adsdevdoo/retro535/docs/pinout.md

# Выводы и разъёмы retro535

Вид сверху. Физические номера, а не номера битов. `_N` означает активный низкий уровень.

## SAB80535-N в PLCC-68

| Вывод | Функция | Цепь платы |
|---|---|---|
| 1 | P4_0 | P4_0 |
| 2 | P4_1 | P4_1 |
| 3 | P4_2 | P4_2 |
| 4 | VPD | GND |
| 5 | P4_3 | P4_3 |
| 6 | P4_4 | P4_4 |
| 7 | P4_5 | P4_5 |
| 8 | P4_6 | P4_6 |
| 9 | P4_7 | P4_7 |
| 10 | RESET_N | RESET_N |
| 11 | VAREF | AVREF |
| 12 | VAGND | GND |
| 13 | AN7 | AN7 |
| 14 | AN6 | AN6 |
| 15 | AN5 | AN5 |
| 16 | AN4 | AN4 |
| 17 | AN3 | AN3 |
| 18 | AN2 | AN2 |
| 19 | AN1 | AN1 |
| 20 | AN0 | AN0 |
| 21 | P3.0/RXD | RXD |
| 22 | P3.1/TXD | TXD |
| 23 | P3.2/P3_2_INT0_N | P3_2_INT0_N |
| 24 | P3.3/P3_3_INT1_N | P3_3_INT1_N |
| 25 | P3.4/P3_4_T0 | P3_4_T0 |
| 26 | P3.5/P3_5_T1 | P3_5_T1 |
| 27 | P3.6/WR_N | WR_N |
| 28 | P3.7/RD_N | RD_N |
| 29 | P1_7 | P1_7 |
| 30 | P1_6 | P1_6 |
| 31 | P1_5 | P1_5 |
| 32 | P1_4 | P1_4 |
| 33 | P1_3 | P1_3 |
| 34 | P1_2 | P1_2 |
| 35 | P1_1 | P1_1 |
| 36 | P1_0 | P1_0 |
| 37 | VBB | VBB |
| 38 | VSS | GND |
| 39 | XTAL2 | XTAL2 |
| 40 | XTAL1 | XTAL1 |
| 41 | P2.0/A8 | A8 |
| 42 | P2.1/A9 | A9 |
| 43 | P2.2/A10 | A10 |
| 44 | P2.3/A11 | A11 |
| 45 | P2.4/A12 | A12 |
| 46 | P2.5/A13 | A13 |
| 47 | P2.6/A14 | A14 |
| 48 | P2.7/A15 | A15 |
| 49 | PSEN_N | PSEN_N |
| 50 | ALE | ALE |
| 51 | EA_N | GND |
| 52 | P0.0/AD0 | D0 |
| 53 | P0.1/AD1 | D1 |
| 54 | P0.2/AD2 | D2 |
| 55 | P0.3/AD3 | D3 |
| 56 | P0.4/AD4 | D4 |
| 57 | P0.5/AD5 | D5 |
| 58 | P0.6/AD6 | D6 |
| 59 | P0.7/AD7 | D7 |
| 60 | P5_7 | P5_7 |
| 61 | P5_6 | P5_6 |
| 62 | P5_5 | P5_5 |
| 63 | P5_4 | P5_4 |
| 64 | P5_3 | P5_3 |
| 65 | P5_2 | P5_2 |
| 66 | P5_1 | P5_1 |
| 67 | P5_0 | P5_0 |
| 68 | VCC | +5V |

P0/AD0…7, P2/A8…15, P3.6/WR#, P3.7/RD#, ALE и PSEN# заняты памятью.
P1/P4/P5 доступны как GPIO; P4.0 также нагружен LED D3. P3.0/P3.1 заняты UART.
Аналоговые AN0…7 отдельны от GPIO. Дополнительные функции GPIO зависят от
SFR и прошивки — здесь указаны базовые имена; см. оригинальный Siemens datasheet.
P1/P3 также имеют таймерные/прерывающие функции. Все порты 5 В TTL.

## J2 — P1

| Контакт | Цепь |
|---|---|
| 1 | P1_0 |
| 2 | P1_1 |
| 3 | P1_2 |
| 4 | P1_3 |
| 5 | P1_4 |
| 6 | P1_5 |
| 7 | P1_6 |
| 8 | P1_7 |
| 9 | +5V |
| 10 | GND |

## J3 — P4

| Контакт | Цепь |
|---|---|
| 1 | P4_0 |
| 2 | P4_1 |
| 3 | P4_2 |
| 4 | P4_3 |
| 5 | P4_4 |
| 6 | P4_5 |
| 7 | P4_6 |
| 8 | P4_7 |
| 9 | +5V |
| 10 | GND |

## J4 — P5

| Контакт | Цепь |
|---|---|
| 1 | P5_0 |
| 2 | P5_1 |
| 3 | P5_2 |
| 4 | P5_3 |
| 5 | P5_4 |
| 6 | P5_5 |
| 7 | P5_6 |
| 8 | P5_7 |
| 9 | +5V |
| 10 | GND |

## J5 — ANALOG

| Контакт | Цепь |
|---|---|
| 1 | AN0 |
| 2 | AN1 |
| 3 | AN2 |
| 4 | AN3 |
| 5 | AN4 |
| 6 | AN5 |
| 7 | AN6 |
| 8 | AN7 |
| 9 | AVREF |
| 10 | GND |

## J6 — P3 / UART

| Контакт | Цепь |
|---|---|
| 1 | RXD |
| 2 | TXD |
| 3 | P3_2_INT0_N |
| 4 | P3_3_INT1_N |
| 5 | P3_4_T0 |
| 6 | P3_5_T1 |
| 7 | RESET_N |
| 8 | GND |

## J7 — BUS RESERVED

| Контакт | Цепь |
|---|---|
| 1 | D0 |
| 2 | D1 |
| 3 | D2 |
| 4 | D3 |
| 5 | D4 |
| 6 | D5 |
| 7 | D6 |
| 8 | D7 |
| 9 | A0 |
| 10 | A1 |
| 11 | A2 |
| 12 | A3 |
| 13 | A4 |
| 14 | A5 |
| 15 | A6 |
| 16 | A7 |
| 17 | A8 |
| 18 | A9 |
| 19 | A10 |
| 20 | A11 |
| 21 | A12 |
| 22 | A13 |
| 23 | A14 |
| 24 | A15 |
| 25 | PSEN_N |
| 26 | ALE |
| 27 | RD_N |
| 28 | WR_N |
| 29 | +5V |
| 30 | GND |

## JP1 — RUN - FIT AFTER FT_PROG

| Контакт | Цепь |
|---|---|
| 1 | PWREN_N |
| 2 | EN_N |

## JP2 — USB RX LINK

| Контакт | Цепь |
|---|---|
| 1 | UART_RX_BUF |
| 2 | RXD |

Двухрядные колодки: пары 1/2, 3/4 и т. д.; не читать один ряд как 1…5.
Квадратная площадка и цифра 1 задают начало нумерации. J7 — только диагностика
шины, без внешних драйверов и длинного шлейфа. JP2 открыть для внешнего источника RXD.
J5.9 AVREF — выход опоры, не подавать на него внешнее напряжение.
Контрольные точки и ожидаемые уровни — в `bring-up.md`.
