adsdevdoo/retro535/reports/release-review.md

# Выпуск retro535 v1.0 — 2026-11-08

Статус: производственные файлы для пробной партии инженерного прототипа.
Работа в железе и DFM на стороне JLCPCB ещё не проверены. Покупку, заказ
и загрузку в JLCPCB агент не выполнял; их выполняет владелец платы.

## Выполненные проверки

| Проверка | Результат / свидетельство |
|---|---|
| KiCad 9.0.2 ERC | 0 ошибок, 0 предупреждений; erc.rpt |
| DRC с проверкой соответствия схеме | 0 violations, 0 unconnected, 0 schematic_parity; drc.json |
| Габарит / слои | 100 × 80 мм по оси контура, 2 слоя; pcb-geometry.json |
| Контур | Замкнут; 8 прямых и 2 дуги, вырез USB 0,81 мм с R0,5 |
| Gerber | Независимо прочитаны Gerbonara: 7 слоёв, верх/низ просмотрены; manufacturing-audit.json |
| Excellon | Каждое отверстие сверено с PCB: 452 круглых PTH, 4 PTH-паза USB, 6 NPTH; допуск сравнения координат 0,0011 мм |
| Архив | 9 файлов, CRC ZIP и SHA-256 каждого вложенного файла проверены; fabrication/SHA256SUMS.txt |
| Шелкография | Обе стороны просмотрены; высота текста ≥1 мм, штрих ≥0,15 мм. Метки первого вывода и разъёмы читаются с одной стороны. TP5/6 и TP7/8 симметричны. |
| 3D | 82 footprints: 68 компонентов имеют локальные модели, исключения — 10 TP и 4 крепёжных отверстия. Проверены верх, низ и наклонный вид; models-audit.json |
| Схема PDF | Четыре листа A3 экспортированы и визуально просмотрены |
| Прошивка | SDCC 4.5; uCsim C52: нормальный запуск, UART и SRAM PASS; намеренное повреждение SRAM даёт FAIL. См. firmware-simulation.json и журналы. |

SHA-256 PCB: `c7ce883b42bb6e790ba64095abc71b3cd030f23d9340032d43f80b06584954aa`.
SHA-256 производственного ZIP:
`d14278da3402d24a2d8b044cfb277295d6679295cfe38f7234b9b80359c70983`.

## Предупреждения и границы проверки

Оставшихся ERC/DRC-предупреждений нет. Первоначальные расхождения NC-сетей,
признака BOM тестовых точек и геометрии локальной библиотеки исправлены,
а не исключены из проверки. Передние PTH-пазы USB увеличены до 0,6 × 1,4 мм
по чертежу HRO; задние 0,6 × 1,7 мм. Край PCB согласован с чертежом.

Gerbonara предупреждает о G90 после заголовка Excellon: это вывод KiCad,
координаты прочитаны как абсолютные и полностью совпали с PCB. При рендере
также сообщает о лишних неиспользованных параметрах RoundRect и отсутствии
paste-слоёв. Слои пасты намеренно не входят в заказ пустых PCB без трафарета.
Эти сообщения не являются подтверждением фабричного DFM.

У U1/U3/U4 на рендерах пустые панели. Модель U1 условная: корпус 30,07 мм
вместо 30,22 мм, в STEP отсутствует один хвост, тогда как PCB имеет все
68 контактов. F1, кварц и прочие типовые корпуса не являются официальным
CAD каждого производителя. Источники и условия распространения — docs/models.md.
Визуальный осмотр не заменяет измерение физических купленных компонентов.

Симулятор C52 проверяет исполняемый код, UART и SRAM, но не электрическую
работу SAB80535-N, ADC, RESET, USB, питание или задержки реальной шины.
Первая прошивка и последующие обновления требуют внешнего программатора
и извлечения Flash при отключённом питании. UART не прошивает эту плату.

JP1 первоначально открыт; FT232RL требуется настроить через FT_PROG на
500 mA и PWREN#. Для надёжного снятия RESET TP3 должен быть выше 4,75 В
под нагрузкой. При длинном кабеле или слабом USB-порту это не гарантировано;
повышающего стабилизатора в v1.0 нет. Следовать docs/bring-up.md.
