adsdevdoo/retro535/docs/models.md

# 3D-модели retro535

Модели находятся в `hardware/3d`, пути в PCB — `${KIPRJMOD}/3d/...`.
Это CAD-визуализация платы 100 × 80 мм, а не фото прототипа. На изображениях
U1, U3, U4 показаны **пустые панели**, без вставленных МК, Flash и SRAM.
JP1/JP2 показаны без съёмных шунтов. Крепёж в отверстиях не установлен.

## Источники и ограничения

| Позиция | Файл / источник | Статус и преобразование |
|---|---|---|
| J1 | `HRO_TYPE-C-31-M-12_aligned.step`; [ai03-2725/Type-C.pretty](https://github.com/ai03-2725/Type-C.pretty/blob/master/HRO%20%20TYPE-C-31-M-12.step) | Сторонняя модель для указанного HRO. Исходник сохранён как `HRO_TYPE-C-31-M-12_ai03.step`. Поворот +90° X, перенос (-4,47; -3,65; 0) мм внесены в STEP. Явная лицензия исходного репозитория не найдена; авторство ai03-2725. Это не официальный CAD HRO. |
| U1, панель | `PLCC68_THT_70207015_illustrative.step`; [LemaruX/Amiga-A600-68k-PLCC2DIP-v2](https://github.com/LemaruX/Amiga-A600-68k-PLCC2DIP-v2/blob/main/3d/70207015.stp) | Иллюстративная THT-панель, не официальный CAD Preci-Dip 540-99-068-24-000-1. Корпус 30,07 мм вместо номинальных 30,22 мм выбранной панели. Перенос (0; -12,7; +7,66) мм, добавлен тёмный цвет. В исходном STEP отсутствует один хвост вывода (позиция pad 2); остальные 67 совпадают с сеткой отверстий. Все 68 площадок PCB сохранены. Не использовать эту модель как шаблон сверления. |
| F1 | `MF-MSMF075_adom_illustrative.step`; [Adom / Ray](https://wiki.adom.inc/adom/mf-msmf075/files/mf-msmf075.step) | Скачанная условная модель 1812, CC-BY-SA-4.0. Габарит XY 4,52 × 3,22 мм. Высота исходника 0,9 мм; в PCB масштаб Z=0,7/0,9 даёт 0,7 мм. [Bourns MF-MSMF](https://www.bourns.com/docs/product-datasheets/mf-msmf.pdf) для MF-MSMF075: A=4,37…4,73; B=3,07…3,41; C=0,55…0,85 мм. Детальная форма и цвет условные. Это не CAD производителя. |
| Y1 | `Crystal_HC49-4H_Vertical.step`, библиотека KiCad | Условный низкий HC49, шаг выводов 4,88 мм. Масштаб Z=3,5/4,1. Исправлен MPN на THT **ECS-110.5-20-4X**, CL20 пФ, 11,0592 МГц. [Чертёж ECS](https://www.ecsxtal.com/store/pdf/hc-49usx.pdf). Подробная форма корпуса не сертифицирована как CAD ECS. |
| Остальные | Локальные копии из установленной KiCad 9, `share/kicad/3dmodels` | Типовые модели соответствующего корпуса; не фирменные модели каждого MPN. Источник: [KiCad packages3D](https://gitlab.com/kicad/libraries/kicad-packages3D), лицензия библиотеки CC-BY-SA-4.0 с исключением KiCad. |

Лицензия исходного репозитория панели — CC-BY-NC-SA-4.0, копия в
`hardware/3d/sources/PLCC68-LICENSE.txt`. В заголовке STEP указан TraceParts;
отдельное разрешение Preci-Dip на эту модель не установлено. При повторном
распространении сохранять авторство, условия и сведения об изменениях.
Условия сторонних моделей не изменяют лицензию остальных файлов проекта.

`reports/models-audit.json` перечисляет **каждый** footprint, файлы моделей,
их SHA-256, смещения, повороты и масштаб. Исключения: десять плоских TP и
четыре крепёжных отверстия. Автоматическая проверка наличия файлов не
доказывает совпадение всех размеров с изделиями. Проверка в 3D — внешний
вид, отсутствие очевидных смещений и совмещение с платой; посадочные места
проверяются отдельно по datasheet. Модель не является основанием менять
нумерацию или координаты площадок.

Для повтора: KiCad Python `tools/complete_models.py`, затем
`tools/audit_models.py`; после этого обязательно открыть рендеры сверху,
снизу и под углом. Генератор схемы сохраняет отредактированные локальные
footprints, а не заменяет их копиями из системной библиотеки.
