adsdevdoo/retro535/docs/architecture.md

# retro535 — архитектура v1.0

Siemens SAB80535-N Retro Development Board. Проект для имеющегося у владельца
**SAB80535-N** в съёмной панели **PLCC-68**. Номинальный размер 100 × 80 мм,
два слоя, FR-4 1,6 мм, 1 oz. Производитель платы — JLCPCB. Физический
прототип не изготовлен и не испытан. Статус выпуска определяется актуальными
отчётами в `reports/`, а не наличием изображения платы.

## Проверенный контроллер

Использован оригинальный скан Siemens **SAB80515/SAB80535**, а не datasheet
SAB80C535. Таблица заказа на странице PDF 2 прямо содержит **SAB80535-N,
Q67120-C241, P-LCC-68, external memory**. Общая документация включает две
микросхемы: утверждения о внутренней ROM у 80515 к нашему 80535 не относятся.

- SAB80535 — микроконтроллер: ядро MCS-51, 256 байт внутренней RAM, GPIO,
  таймеры, UART и 8-канальный 8-битный АЦП. Внутренней памяти программ нет.
- Питание 5 В ±10%, исполнение -N: 0…70 °C. Допустимый диапазон частот
  1,2…12 МГц; выбран кварц 11,0592 МГц для точного UART 9600 бод.
- **RESET, вывод 10, активен НИЗКИМ уровнем.** Это принципиальное отличие
  от многих других MCS-51. Минимальная длительность сброса — 24 периода
  работающего генератора. MCP120-475I/SN удерживает сброс после восстановления
  питания минимум 150 мс; R7 10 кОм подтягивает линию вверх, SW1 замыкает её
  на землю. Порог MCP120-475: 4,50…4,75 В; гарантированный выход из сброса
  требует питания выше 4,75 В.
- **EA, вывод 51, постоянно на GND**: все команды читаются извне.
- **VBB, вывод 37: только C12 100 нФ на GND.** Это вывод внутреннего
  смещения подложки; его нельзя непосредственно соединять с GND или +5 В.
- VPD, вывод 4, на GND: резервное питание внутренней RAM не используется.
- VCC=68, VSS=38; VAREF=11, VAGND=12. Аналоговая опора от +5 В через R8
  10 Ом, с 100 нФ и 1 мкФ. Это отфильтрованное питание, не прецизионный
  источник. Падение на R8 и шум питания нужно измерить и учитывать при АЦП.
- XTAL1=40, XTAL2=39. Кварц ECS-110.5-20-4X (THT HC-49USX, шаг 4,88 мм,
  высота до 3,5 мм), два C0G по 30 пФ. Первоначальный ABLS ошибочно
  соответствовал SMD-корпусу; MPN исправлен, отверстия платы не изменены.
  Siemens рекомендует 30±10 пФ. Эквивалентная нагрузка двух конденсаторов
  около 15 пФ плюс паразитная ёмкость; точность частоты и запуск проверяются
  на прототипе. Концы неполярного кварца можно поменять местами.
- ALE=50, PSEN=49. Внешние схемы не должны активно управлять ими при сбросе:
  эти линии участвуют в заводских тестовых режимах. Внешних драйверов нет.
- P0.0…P0.7=52…59: мультиплексированная шина AD0…AD7. В режиме внешней
  памяти у порта есть внутренние активные подтяжки; внешние резисторы не нужны.
- P2.0…P2.7=41…48: A8…A15. P3.6=27 — WR#, P3.7=28 — RD#.
- AN0…AN7=20…13: подтяжки 100 кОм к GND задают уровни отключённых входов.
  Они нагружают внешние источники. Неиспользованные GPIO остаются входами
  квазидвунаправленных портов после сброса; не замыкать их напрямую на питание.

Подробная таблица всех физических выводов и разъёмов — `pinout.md`.

## Карта памяти и внешняя шина

| Пространство | Адреса | Устройство | Управление |
|---|---|---|---|
| CODE | 0000h…FFFFh | Нижние 64 КиБ SST39SF010A | CE#=0; OE#=PSEN#; WE#=+5 В |
| XDATA | 0000h…7FFFh | 32 КиБ AS6C62256A | CE#=A15; OE#=RD#; WE#=WR# |
| XDATA | 8000h…FFFFh | Не установлено | Чтение не определено |
| Внутренняя RAM | 00h…FFh | 256 байт внутри МК | Верхняя половина — косвенная адресация |
| SFR | 80h…FFh | Регистры периферии | Прямая адресация; отдельна от RAM |

CODE и XDATA — **разные пространства по 64 КиБ**, не единая линейная память
128 КиБ. Команды читаются через PSEN#, данные через MOVX и RD#/WR#.
SN74HCT573 захватывает A0…A7 с AD0…AD7 по ALE; OE# защёлки постоянно низкий.
При CODE-чтении SRAM не выдаёт данные, потому что RD# не активен. При MOVX
Flash не выдаёт данные, потому что PSEN# не активен. Эти условия исключают
одновременное управление шиной со стороны двух памятей в штатных циклах.

SST39SF010A имеет 128 КиБ, но **A16 (вывод 2) жёстко на GND**. Используются
физические адреса 00000h…0FFFFh; 10000h…1FFFFh недоступны. Банкового регистра
в v1.0 нет. CE#, OE#, WE# и все адресные входы имеют определённые подключения.
NC выводы 1 и 30 действительно не подключены. RD#/WR# подтянуты к +5 В
через 10 кОм; Flash WE# не связан с WR#.

74HCT139 не установлен: для одного окна SRAM 32 КиБ достаточно A15 прямо на
активный низкий CE#. Дополнительный дешифратор добавлял бы задержку и
потребление без необходимой функции.

## Выбор компонентов и уровни

| Узел | Выбор | Причина |
|---|---|---|
| Панель U1 | Preci-Dip 540-99-068-24-000-1 | Съёмный PLCC-68, сквозные выводы |
| Защёлка U2 | SN74HCT573DWR | TTL-пороги, SOIC-20W с шагом 1,27 мм |
| CODE U3 | SST39SF010A-70-4C-PHE | 5 В, 70 нс, PDIP32 в панели |
| XDATA U4 | AS6C62256A-70PCN | 5 В, 70 нс, PDIP28; VIH=2,2 В |
| USB-UART U5 | FT232RL | Настраиваемые 500 мА и PWREN# для питания после enumeration |
| Питание U6 | TPS2041BDR | Ключ с ограничением тока/температуры, активный низкий EN |
| Сброс U7 | MCP120-475I/SN | Активный низкий открытый сток; контроль просадки |
| UART U8 | SN74AHCT125DR | TTL-входы и отключаемые выходы при сбросе/выключенном МК |

Siemens гарантирует VOH ≥2,4 В, а не близкий к питанию CMOS-уровень.
Поэтому HCT/AHCT предпочтительны HC/AHC: их VIH=2,0 В. У SST39SF010A
также TTL-пороги. Первоначальный кандидат **AS6C62256 без A** имеет VIH=2,4 В:
формально верхний уровень совпадает с минимумом выхода МК, запаса нет.
Поэтому выбрана **AS6C62256A** с VIH=2,2 В: гарантированный статический запас
0,2 В. Это небольшой запас; шину нельзя произвольно удлинять или нагружать.
AS6C62256A — устаревшая позиция; перед закупкой проверить подлинность и наличие.
Не заменять её на похожую 62256 без повторной проверки VIH, тока и времени.

По низкому уровню VO(L) МК ≤0,45 В при оговорённых токах ниже входного
порога 0,8 В памятей и TTL-логики. Выходы памяти VOH ≥2,4 В также подходят
к входам МК с VIH=2,0 В. Светодиод P4.0 включён на сток через 3,3 кОм:
ток менее 1,6 мА даже при верхнем питании и низком прямом падении LED.
Нагрузки GPIO учитывать по ограничениям отдельных выводов и портов Siemens.

CH340C электрически пригоден для UART, но в этой архитектуре заменён на
FT232RL из-за документированных PWREN# и программируемого описателя питания.
Сам МК может потреблять до 210 мА: включать всю плату сразу как USB 2.0
устройство начальной нагрузки 100 мА нельзя. Замена сделана ради управления
питанием, не ради программирования МК через UART.

## Тактирование и временной бюджет

При 11,0592 МГц T=90,422 нс. Ниже — расчёт по таблицам Siemens для обычного
внешнего цикла и максимальным задержкам выбранных устройств. Это статическая
проверка совместимости, не измерение реальных фронтов.

| Проверка | Допускает/обеспечивает МК, нс | Требуется устройству, нс | Запас, нс |
|---|---:|---:|---:|
| ALE→валидные команды | 4T−100=261,69 | HCT LE→Q 65 + Flash 70 =135 | 126,69 |
| PSEN#→валидные команды | 3T−100=171,27 | Flash OE# 35 | 136,27 |
| Высокий адрес→команды | 5T−115=337,11 | Flash 70 | 267,11 |
| Адрес до закрытия ALE | T−30=60,42 | HCT setup 13 | 47,42 |
| Адрес после ALE | T−35=55,42 | HCT hold 5 | 50,42 |
| RD#→данные XDATA | 5T−165=287,11 | SRAM 70 (консервативно вместо более короткого OE) | 217,11 |
| ALE→данные XDATA | 8T−150=573,38 | HCT 65 + SRAM 70 =135 | 438,38 |
| Импульс WR# | 6T−100=442,53 | SRAM tWP 55 | 387,53 |
| Адрес/CE# до конца записи | ≥6T−100=442,53 (адрес уже устойчив до WR#) | SRAM tAW/tCW 65 | ≥377,53 |
| Данные до конца WR# | 7T−150=482,95 | SRAM tDS 30 | 452,95 |
| Данные после WR# | T−50=40,42 | SRAM tDH 0 | 40,42 |
| Адрес до начала WR# | ALE→WR# ≥3T−50=221,27 минус HCT 65 | SRAM tAS 0 | ≥156,27 |
| Адрес после WR# | WR#→ALE high ≥T−40=50,42; до этого защёлка закрыта | SRAM tAH 0 | ≥50,42 |
| Flash освобождает шину после PSEN# | T−20=70,42 максимально разрешено | SST TOHZ ≤25 | 45,42 |
| SRAM освобождает шину после RD# | 2T−70=110,84 максимально разрешено | SRAM tHZOE ≤25 | 85,84 |

Для HCT взят более медленный случай нагрузки 150 пФ. Это не разрешение
нагружать ALE или шину произвольно: ограничения нагрузки самого МК сохраняются.
Для 70-нс SST39SF010A TOHZ=25 нс (не значение 20 нс для более быстрого
исполнения). Для SRAM использованы таблицы на стр. 5, диаграммы на стр. 8–9;
при записи OE#=RD# остаётся высоким, поэтому SRAM не управляет шиной.
МК требует нулевое удержание данных после PSEN#/RD#; адрес после PSEN#
остаётся устойчивым ≥T−8=82,42 нс. Минимальный цикл МК 12T=1085,07 нс
намного длиннее tRC/tWC=70 нс SRAM. Электрические задержки приведены при
ограничениях нагрузки из datasheet, не с произвольным внешним шлейфом.
Проверить фронты, OE-disable и удержание данных на физическом прототипе;
не подключать к J7 длинный шлейф, светодиоды или низкоомные входы. J7 в v1.0 —
разъём диагностики, не рассчитанная на произвольное расширение системная шина.

## USB, питание и состояние при сбросе

USB-C HRO TYPE-C-31-M-12: независимые Rd 5,1 кОм на CC1 и CC2, 5 В от VBUS,
без USB-PD. Дубли D+/D− соединены. SBU не используются. Экран соединён с GND.
USBLC6-2SC6 защищает линии данных от ESD; F1 MF-MSMF075-2 — самовосстанавливающийся
предохранитель, FB1 — феррит. Это не защита от подачи произвольного DC-напряжения.

Постоянная шина +5V_USB питает FT232RL и UART-буферы. Основная +5V, включая
МК, память и аналоговую часть, включается TPS2041B только после USB enumeration.
**JP1 при первой сборке открыт**. Сначала FT_PROG записывает bus-powered 500 мА,
CBUS3=PWREN#, Pull-down on suspend=enabled; затем питание отключают и ставят JP1.
В режиме USB suspend основная часть отключается. Автономный старт от зарядного
устройства без USB host/enumeration в v1.0 не предусмотрен.

Порядок управления: RESET# низкий → Q1 закрыт → OE# буфера подтянут к +5V_USB →
оба выхода UART отключены. После включения +5V и окончания сброса Q1 включает
буферы. Это предотвращает подпитку выключенного МК с FT232 TX. VCCIO FT232
остаётся на +5V_USB, чтобы PWREN# работал при выключенном основном питании.
Неиспользованные входы U8 имеют фиксированные уровни; R15 задаёт низкий TXD,
когда основная часть выключена. JP2 размыкают при подаче RX от внешнего адаптера.

Оценка нагрузки: МК до 210 мА + SRAM до 70 мА + Flash до 25 мА =305 мА;
FT232 типично 15 мА (datasheet не задаёт здесь максимума), плюс логика, LED,
опора и потери. Для них резервируется около 70 мА, внешний ток разъёмов
ограничить 50 мА до измерений. Это проектный бюджет, не доказанный предельный
ток всей платы. При первом включении измерить ток, запуск и просадку +5V.

**Ограничение USB-питания:** нужен короткий качественный кабель и порт/хаб,
сохраняющий **более 4,75 В на TP3 под нагрузкой**. На нижнем пределе USB VBUS
после падения в кабеле, PTC, феррите и ключе это не гарантируется; MCP120-475
может удерживать плату в сбросе. Повышающего стабилизатора нет. Не обходить
супервизор и не подавать второе питание параллельно USB. Если напряжение
недостаточно, сменить кабель/питаемый хаб; надёжность при любом USB-хосте
не заявляется. При просадках XDATA теряется; Flash защищена от записи аппаратно.

## Механика панели

Каталог Preci-Dip, печатная страница 94 (PDF 87): 540-99-068-24-000-1,
корпус 30,22 мм, внешний квадрат центров выводов 25,40 мм, внутренний 20,32 мм,
шаг сетки 2,54 мм, минимальный диаметр отверстия 0,75 мм. Выбран 0,8 мм.
Нумерация сверена после поворота чертежа на 180°: pin 1 сверху, затем против
часовой стрелки при виде сверху. Pin 1 квадратный; на шелкографии есть ключ.
Сохранён консервативный контур установки штатной KiCad PLCC-68 THT socket.
3D-модель не является доказательством соответствия панели: решающи чертёж,
нумерация и расстояния между центрами отверстий. Перед пайкой приложить
реальную панель к распечатке 1:1 или к первой изготовленной плате.

## Имеющиеся дополнительные детали

Владелец сообщил **NEC D4365C-12L** и **SN74LS373N**. Они не включены в BOM v1.0.
Для D4365C-12L точный оригинальный datasheet пока не подтверждён; нельзя
автоматически подменять обозначение на похожий D4364C или считать её 62256.
SN74LS373N — TTL-защёлка в DIP20, но её распиновка отличается от 74HCT573,
потребление и нагрузка на шину тоже. Возможная отдельная ревизия с ней требует
изменения схемы/посадочного места и повторного расчёта. Просто вставить её
в предусмотренное место U2 нельзя.

Источники: `sources.md`. Прошивка и первое включение: `bring-up.md`.
