adsdevdoo/retro535/images/gerber-bottom.png

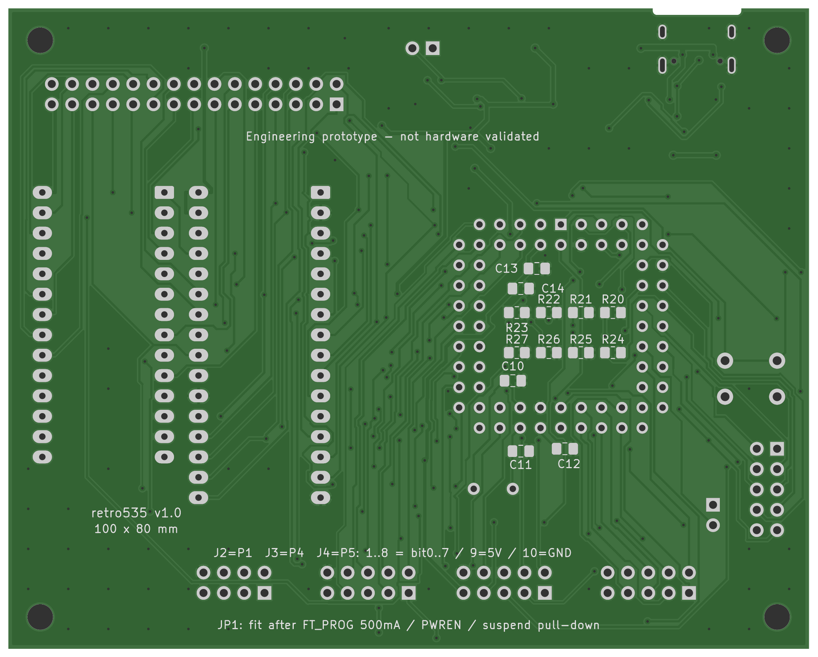
images/gerber-bottom.png
