adsdevdoo/retro535/images/gerber-top.png

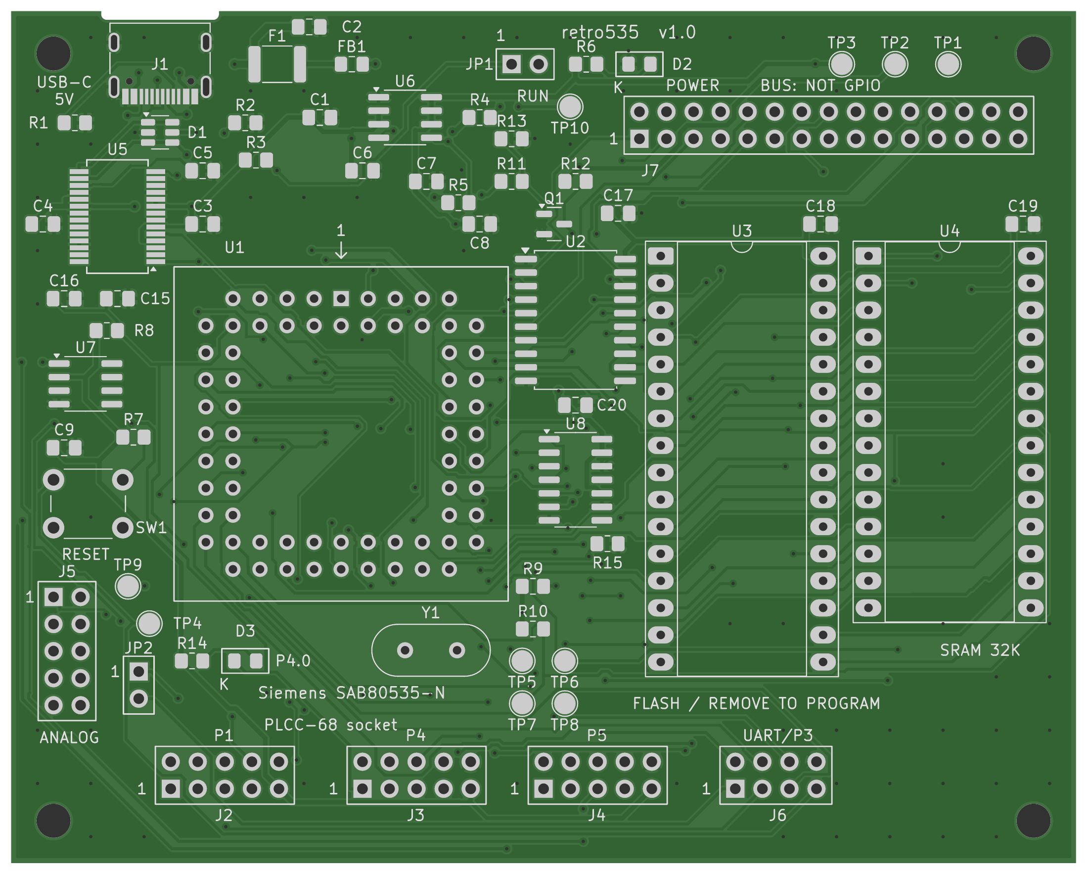
images/gerber-top.png
