adsdevdoo/retro535/images/retro535-angle.png

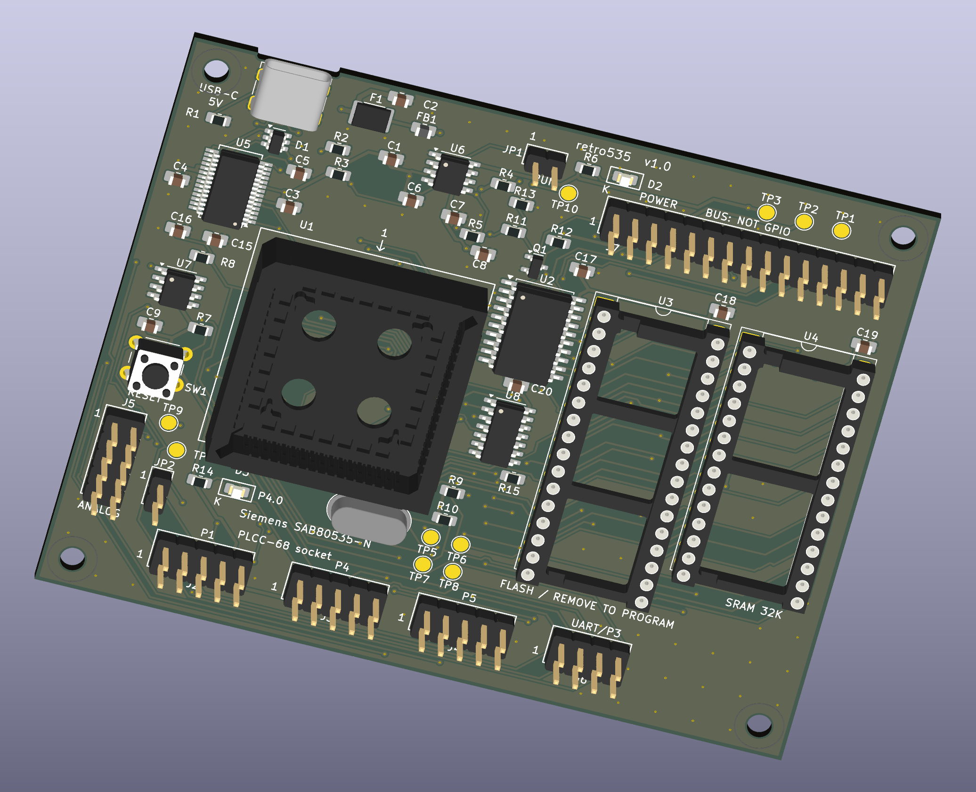
images/retro535-angle.png
