adsdevdoo/retro535/images/retro535-bottom.png

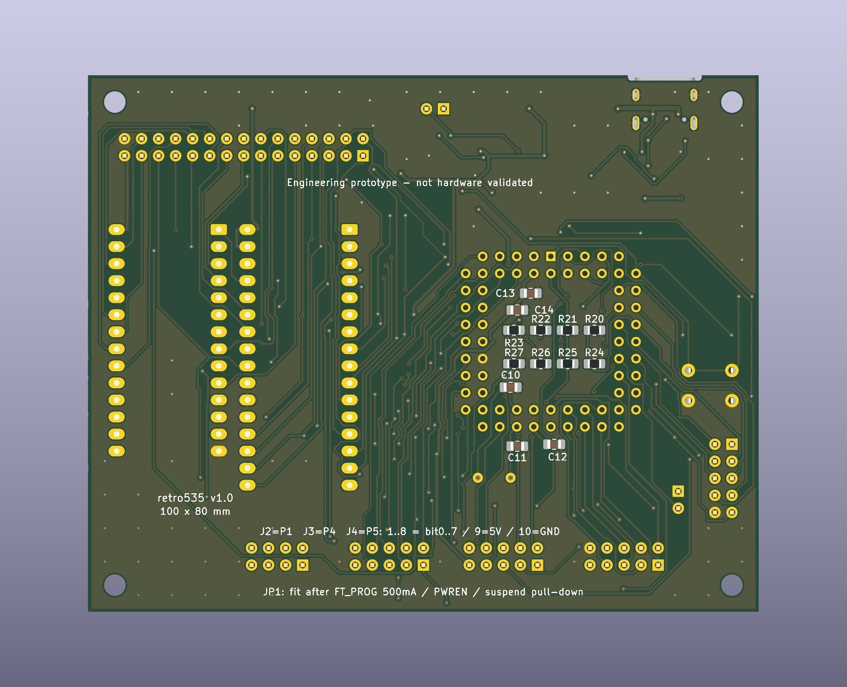
images/retro535-bottom.png
