adsdevdoo/retro535/docs/BOM.csv

Reference | Qty | Value | MPN | Footprint | Datasheet | Notes
U1 | 1 | SAB80535-N | SAB80535-N | Retro535:PLCC68_PreciDip_540-99-068-24-000-1 | https://www.ardent-tool.com/datasheets/Siemens_SAB80515_80535.pdf | Supplied by user; socket listed separately
U2 | 1 | 74HCT573 | SN74HCT573DWR | Retro535:SOIC-20W_7.5x12.8mm_P1.27mm | https://www.ti.com/lit/ds/symlink/sn74hct573.pdf
U3 | 1 | SST39SF010A-70-4C-PHE | SST39SF010A-70-4C-PHE | Retro535:DIP-32_W15.24mm_Socket_LongPads | https://ww1.microchip.com/downloads/aemDocuments/documents/MPD/ProductDocuments/DataSheets/SST39SF010A-SST39SF020A-SST39SF040-Data-Sheet-DS20005022.pdf
U4 | 1 | AS6C62256A-70PCN | AS6C62256A-70PCN | Retro535:DIP-28_W15.24mm_Socket_LongPads | https://www.alliancememory.com/wp-content/uploads/AS6C62256A-70PCN_AS6C62256A.pdf | EOL; no substitution without level review
J1 | 1 | USB-C | TYPE-C-31-M-12 | Retro535:USB_C_Receptacle_HRO_TYPE-C-31-M-12 | https://datasheet.lcsc.com/datasheet/pdf/9e56b777c022540fcce7c7f67825f55e.pdf
R1 | 1 | 5.1k | RC0805FR-075K1L | Retro535:R_0805_2012Metric_Pad1.20x1.40mm_HandSolder
R2 | 1 | 5.1k | RC0805FR-075K1L | Retro535:R_0805_2012Metric_Pad1.20x1.40mm_HandSolder
F1 | 1 | 0.75A PTC | MF-MSMF075-2 | Retro535:Fuse_1812_4532Metric
FB1 | 1 | 600R@100MHz | BLM21PG601SN1D | Retro535:L_0805_2012Metric_Pad1.15x1.40mm_HandSolder
C1 | 1 | 4.7u | GRM21BR61C475KA73L | Retro535:C_0805_2012Metric_Pad1.18x1.45mm_HandSolder
C2 | 1 | 100n | GRM21BR71H104KA01L | Retro535:C_0805_2012Metric_Pad1.18x1.45mm_HandSolder
D1 | 1 | USBLC6-2SC6 | USBLC6-2SC6 | Retro535:SOT-23-6 | https://www.st.com/resource/en/datasheet/usblc6-2.pdf
U5 | 1 | FT232RL | FT232RL | Retro535:SSOP-28_5.3x10.2mm_P0.65mm | https://ftdichip.cn/Support/Documents/DataSheets/ICs/DS_FT232R.pdf
C3 | 1 | 100n | GRM21BR71H104KA01L | Retro535:C_0805_2012Metric_Pad1.18x1.45mm_HandSolder
C4 | 1 | 100n | GRM21BR71H104KA01L | Retro535:C_0805_2012Metric_Pad1.18x1.45mm_HandSolder
C5 | 1 | 100n | GRM21BR71H104KA01L | Retro535:C_0805_2012Metric_Pad1.18x1.45mm_HandSolder
U6 | 1 | TPS2041BDR | TPS2041BDR | Retro535:SOIC-8_3.9x4.9mm_P1.27mm | https://www.ti.com/lit/ds/symlink/tps2041b.pdf
R3 | 1 | 10k | RC0805FR-0710KL | Retro535:R_0805_2012Metric_Pad1.20x1.40mm_HandSolder
R4 | 1 | 10k | RC0805FR-0710KL | Retro535:R_0805_2012Metric_Pad1.20x1.40mm_HandSolder
JP1 | 1 | RUN - FIT AFTER FT_PROG | M20-9990245 | Retro535:PinHeader_1x02_P2.54mm_Vertical |  | Fit only after USB provisioning
R5 | 1 | 10k | RC0805FR-0710KL | Retro535:R_0805_2012Metric_Pad1.20x1.40mm_HandSolder
C6 | 1 | 100n | GRM21BR71H104KA01L | Retro535:C_0805_2012Metric_Pad1.18x1.45mm_HandSolder
C7 | 1 | 4.7u | GRM21BR61C475KA73L | Retro535:C_0805_2012Metric_Pad1.18x1.45mm_HandSolder
C8 | 1 | 100n | GRM21BR71H104KA01L | Retro535:C_0805_2012Metric_Pad1.18x1.45mm_HandSolder
R6 | 1 | 2.2k | RC0805FR-072K2L | Retro535:R_0805_2012Metric_Pad1.20x1.40mm_HandSolder
D2 | 1 | POWER green | LTST-C170KGKT | Retro535:LED_0805_2012Metric_Pad1.15x1.40mm_HandSolder
U7 | 1 | MCP120-475I/SN | MCP120-475I/SN | Retro535:SOIC-8_3.9x4.9mm_P1.27mm | https://ww1.microchip.com/downloads/en/DeviceDoc/11184D.pdf
R7 | 1 | 10k | RC0805FR-0710KL | Retro535:R_0805_2012Metric_Pad1.20x1.40mm_HandSolder
SW1 | 1 | RESET | B3F-1000 | Retro535:SW_PUSH_6mm
C9 | 1 | 100n | GRM21BR71H104KA01L | Retro535:C_0805_2012Metric_Pad1.18x1.45mm_HandSolder
Y1 | 1 | 11.0592MHz CL20p | ECS-110.5-20-4X | Retro535:Crystal_HC49-U_Vertical | https://www.ecsxtal.com/store/pdf/hc-49usx.pdf
C10 | 1 | 30p | GRM2165C1H300JA01D | Retro535:C_0805_2012Metric_Pad1.18x1.45mm_HandSolder
C11 | 1 | 30p | GRM2165C1H300JA01D | Retro535:C_0805_2012Metric_Pad1.18x1.45mm_HandSolder
C12 | 1 | 100n | GRM21BR71H104KA01L | Retro535:C_0805_2012Metric_Pad1.18x1.45mm_HandSolder
C13 | 1 | 100n | GRM21BR71H104KA01L | Retro535:C_0805_2012Metric_Pad1.18x1.45mm_HandSolder
C14 | 1 | 1u | GRM21BR71C105KA01L | Retro535:C_0805_2012Metric_Pad1.18x1.45mm_HandSolder
R8 | 1 | 10 | RC0805FR-0710RL | Retro535:R_0805_2012Metric_Pad1.20x1.40mm_HandSolder
C15 | 1 | 100n | GRM21BR71H104KA01L | Retro535:C_0805_2012Metric_Pad1.18x1.45mm_HandSolder
C16 | 1 | 1u | GRM21BR71C105KA01L | Retro535:C_0805_2012Metric_Pad1.18x1.45mm_HandSolder
R20 | 1 | 100k | RC0805FR-07100KL | Retro535:R_0805_2012Metric_Pad1.20x1.40mm_HandSolder
R21 | 1 | 100k | RC0805FR-07100KL | Retro535:R_0805_2012Metric_Pad1.20x1.40mm_HandSolder
R22 | 1 | 100k | RC0805FR-07100KL | Retro535:R_0805_2012Metric_Pad1.20x1.40mm_HandSolder
R23 | 1 | 100k | RC0805FR-07100KL | Retro535:R_0805_2012Metric_Pad1.20x1.40mm_HandSolder
R24 | 1 | 100k | RC0805FR-07100KL | Retro535:R_0805_2012Metric_Pad1.20x1.40mm_HandSolder
R25 | 1 | 100k | RC0805FR-07100KL | Retro535:R_0805_2012Metric_Pad1.20x1.40mm_HandSolder
R26 | 1 | 100k | RC0805FR-07100KL | Retro535:R_0805_2012Metric_Pad1.20x1.40mm_HandSolder
R27 | 1 | 100k | RC0805FR-07100KL | Retro535:R_0805_2012Metric_Pad1.20x1.40mm_HandSolder
C17 | 1 | 100n | GRM21BR71H104KA01L | Retro535:C_0805_2012Metric_Pad1.18x1.45mm_HandSolder
C18 | 1 | 100n | GRM21BR71H104KA01L | Retro535:C_0805_2012Metric_Pad1.18x1.45mm_HandSolder
C19 | 1 | 100n | GRM21BR71H104KA01L | Retro535:C_0805_2012Metric_Pad1.18x1.45mm_HandSolder
R9 | 1 | 10k | RC0805FR-0710KL | Retro535:R_0805_2012Metric_Pad1.20x1.40mm_HandSolder
R10 | 1 | 10k | RC0805FR-0710KL | Retro535:R_0805_2012Metric_Pad1.20x1.40mm_HandSolder
U8 | 1 | 74AHCT125 | SN74AHCT125DR | Retro535:SOIC-14_3.9x8.7mm_P1.27mm | https://www.ti.com/lit/ds/symlink/sn74ahct125.pdf
Q1 | 1 | MMBT3904 | MMBT3904 | Retro535:SOT-23
R11 | 1 | 47k | RC0805FR-0747KL | Retro535:R_0805_2012Metric_Pad1.20x1.40mm_HandSolder
R12 | 1 | 10k | RC0805FR-0710KL | Retro535:R_0805_2012Metric_Pad1.20x1.40mm_HandSolder
R13 | 1 | 100k | RC0805FR-07100KL | Retro535:R_0805_2012Metric_Pad1.20x1.40mm_HandSolder
C20 | 1 | 100n | GRM21BR71H104KA01L | Retro535:C_0805_2012Metric_Pad1.18x1.45mm_HandSolder
R15 | 1 | 100k | RC0805FR-07100KL | Retro535:R_0805_2012Metric_Pad1.20x1.40mm_HandSolder
JP2 | 1 | USB RX LINK | M20-9990245 | Retro535:PinHeader_1x02_P2.54mm_Vertical
R14 | 1 | 3.3k | RC0805FR-073K3L | Retro535:R_0805_2012Metric_Pad1.20x1.40mm_HandSolder
D3 | 1 | USER P4.0 active LOW | LTST-C170KRKT | Retro535:LED_0805_2012Metric_Pad1.15x1.40mm_HandSolder
J2 | 1 | P1 | M20-9980546 | Retro535:PinHeader_2x05_P2.54mm_Vertical
J3 | 1 | P4 | M20-9980546 | Retro535:PinHeader_2x05_P2.54mm_Vertical
J4 | 1 | P5 | M20-9980546 | Retro535:PinHeader_2x05_P2.54mm_Vertical
J5 | 1 | ANALOG | M20-9980546 | Retro535:PinHeader_2x05_P2.54mm_Vertical
J6 | 1 | P3 / UART | M20-9980446 | Retro535:PinHeader_2x04_P2.54mm_Vertical
J7 | 1 | BUS RESERVED | M20-9981546 | Retro535:PinHeader_2x15_P2.54mm_Vertical
TP1 | 1 | GND | PCB test pad | Retro535:TestPoint_Pad_D2.0mm
TP2 | 1 | +5V_USB | PCB test pad | Retro535:TestPoint_Pad_D2.0mm
TP3 | 1 | +5V | PCB test pad | Retro535:TestPoint_Pad_D2.0mm
TP4 | 1 | RESET_N | PCB test pad | Retro535:TestPoint_Pad_D2.0mm
TP5 | 1 | ALE | PCB test pad | Retro535:TestPoint_Pad_D2.0mm
TP6 | 1 | PSEN_N | PCB test pad | Retro535:TestPoint_Pad_D2.0mm
TP7 | 1 | RD_N | PCB test pad | Retro535:TestPoint_Pad_D2.0mm
TP8 | 1 | WR_N | PCB test pad | Retro535:TestPoint_Pad_D2.0mm
TP9 | 1 | AVREF | PCB test pad | Retro535:TestPoint_Pad_D2.0mm
TP10 | 1 | OC_N | PCB test pad | Retro535:TestPoint_Pad_D2.0mm
U1 socket | 1 | PLCC-68 THT | 540-99-068-24-000-1 | Retro535:PLCC68_PreciDip_540-99-068-24-000-1 | https://static.chipdip.ru/lib/825/DOC031825282.pdf | Preci-Dip, catalogue p94
U3 socket | 1 | DIP32 600mil | 110-93-632-41-001000 | included with U3 |  | Mill-Max; 2.54mm pitch
U4 socket | 1 | DIP28 600mil | 110-93-628-41-001000 | included with U4 |  | Mill-Max; 2.54mm pitch
JP1/JP2 shunts | 2 | 2.54mm shunt | QPC02SXGN-RC | n/a |  | Sullins; fit JP1 only after FT_PROG provisioning
