adsdevdoo/retro535/hardware/3d/sources/MF-MSMF075_adom.step

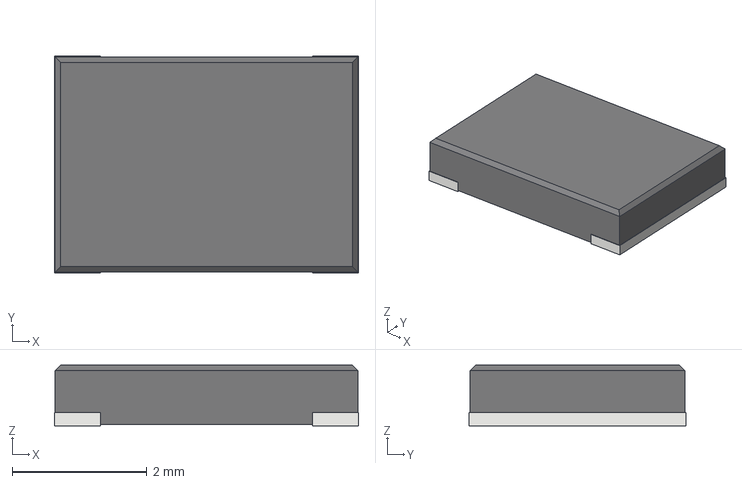
[picture p7: CAD file, 2026-11-08]
hardware/3d/sources/MF-MSMF075_adom.step
4.52 x 3.22 x 0.9 mm
