adsdevdoo/retro535/hardware/3d/PinHeader_2x05_P2.54mm_Vertical.step

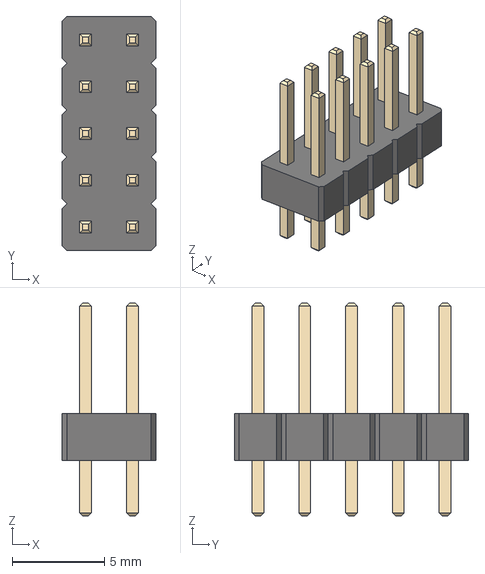
[picture p8: CAD file, 2026-11-08]
hardware/3d/PinHeader_2x05_P2.54mm_Vertical.step
5.08 x 12.7 x 11.5 mm
