adsdevdoo/retro535/hardware/3d/HRO_TYPE-C-31-M-12_ai03.step

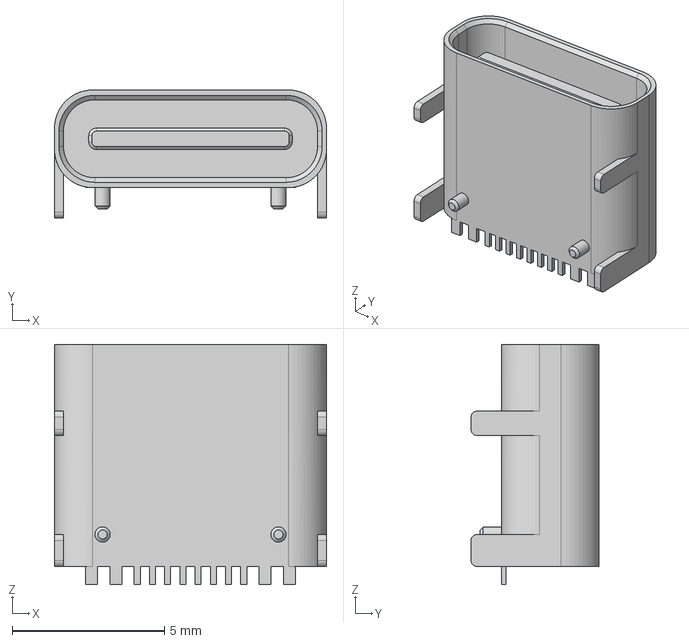
[picture p10: CAD file, 2026-11-08]
hardware/3d/HRO_TYPE-C-31-M-12_ai03.step
8.94 x 4.21 x 7.90 mm
