adsdevdoo/retro535/hardware/3d/SOIC-8_3.9x4.9mm_P1.27mm.step

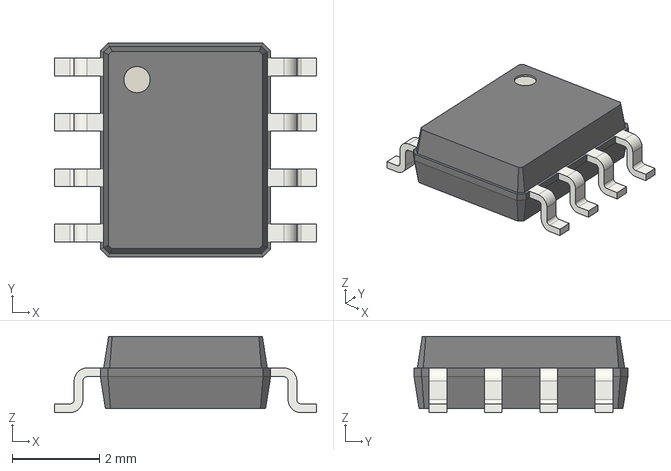
[picture p11: CAD file, 2026-11-08]
hardware/3d/SOIC-8_3.9x4.9mm_P1.27mm.step
6.00 x 4.90 x 1.75 mm
