adsdevdoo/retro535/hardware/3d/SOT-23.step

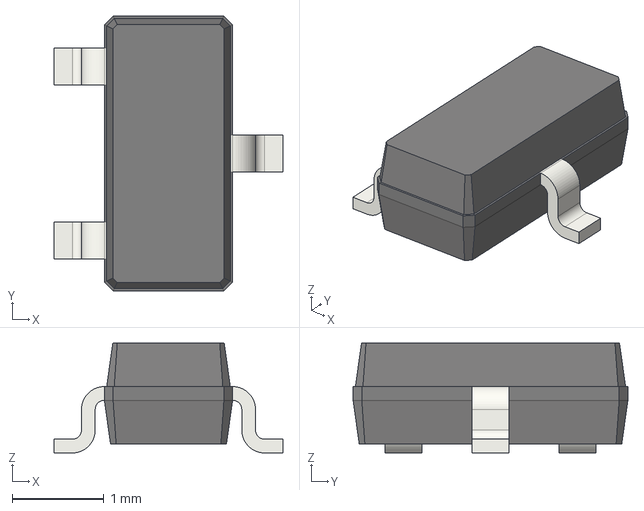
[picture p12: CAD file, 2026-11-08]
hardware/3d/SOT-23.step
2.50 x 3.00 x 1.20 mm
