adsdevdoo/retro535/hardware/3d/Crystal_HC49-4H_Vertical.step

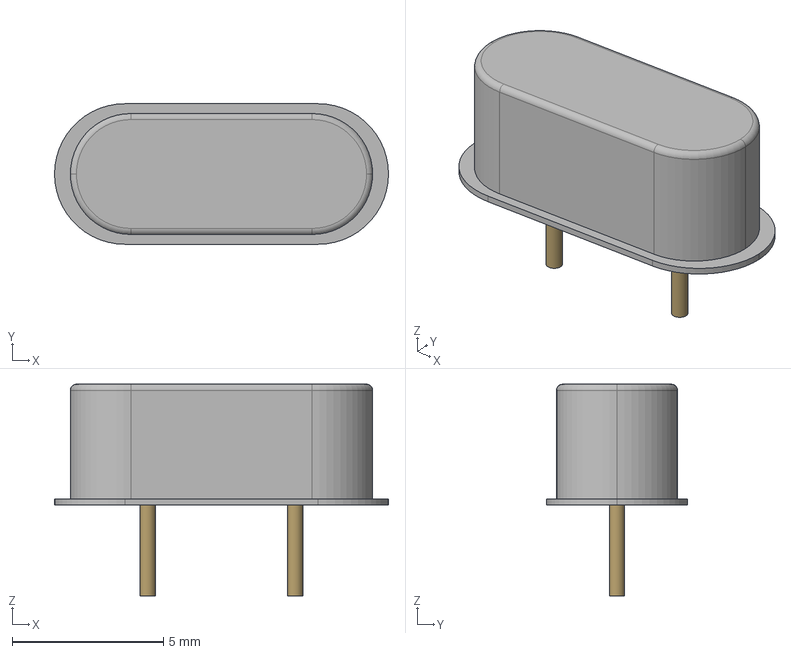
[picture p13: CAD file, 2026-11-08]
hardware/3d/Crystal_HC49-4H_Vertical.step
11.1 x 4.65 x 7.00 mm
