adsdevdoo/retro535/hardware/3d/SW_PUSH_6mm.step

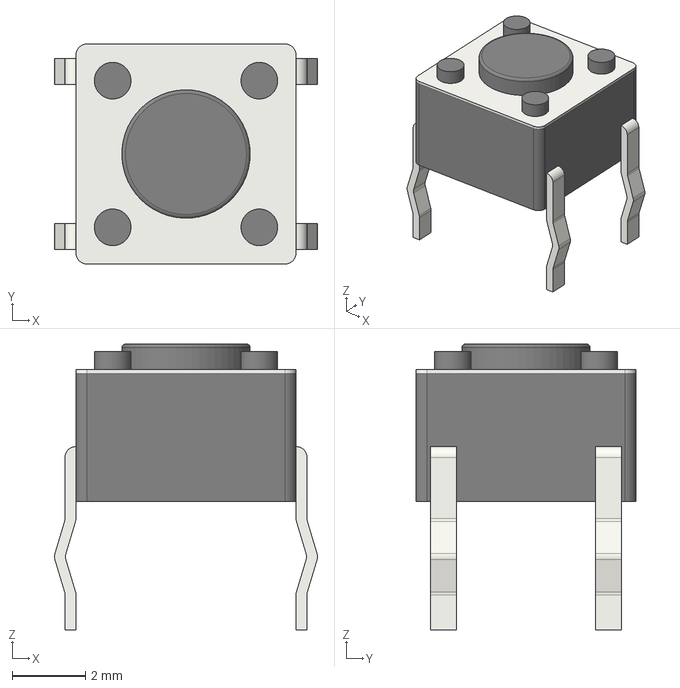
[picture p14: CAD file, 2026-11-08]
hardware/3d/SW_PUSH_6mm.step
7.17 x 6.00 x 7.80 mm
