adsdevdoo/retro535/hardware/3d/DIP-32_W15.24mm_Socket.step

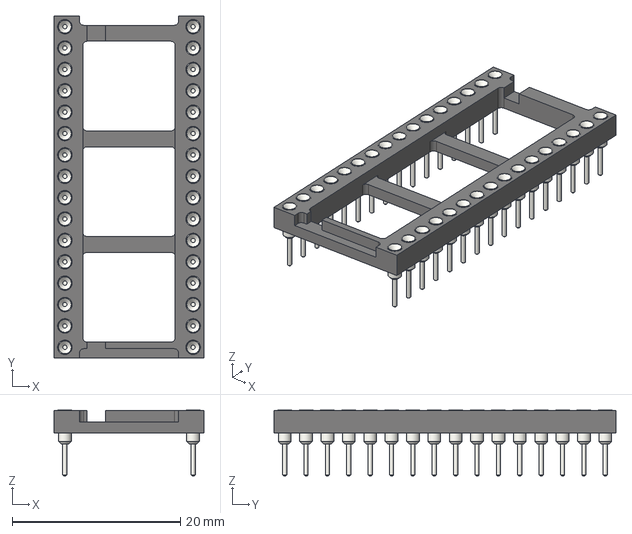
[picture p15: CAD file, 2026-11-08]
hardware/3d/DIP-32_W15.24mm_Socket.step
17.8 x 40.6 x 7.79 mm
