adsdevdoo/retro535/hardware/3d/SOT-23-6.step

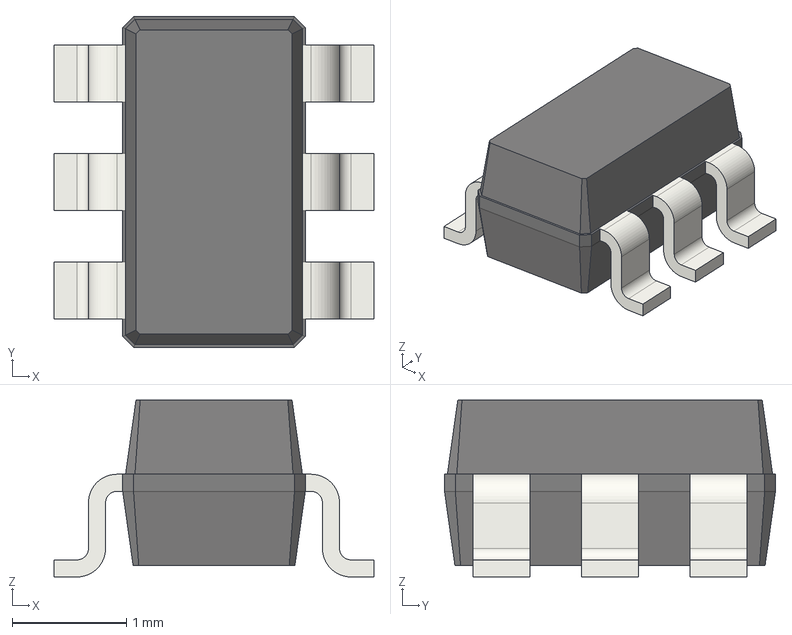
[picture p16: CAD file, 2026-11-08]
hardware/3d/SOT-23-6.step
2.80 x 2.90 x 1.55 mm
