adsdevdoo/retro535/hardware/3d/DIP-28_W15.24mm_Socket.step

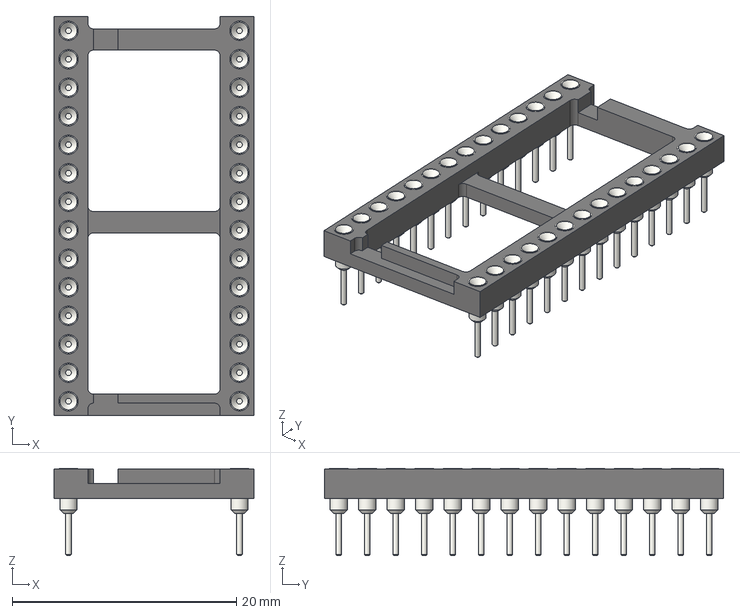
[picture p17: CAD file, 2026-11-08]
hardware/3d/DIP-28_W15.24mm_Socket.step
17.8 x 35.6 x 7.79 mm
