adsdevdoo/retro535/hardware/3d/PinHeader_1x02_P2.54mm_Vertical.step

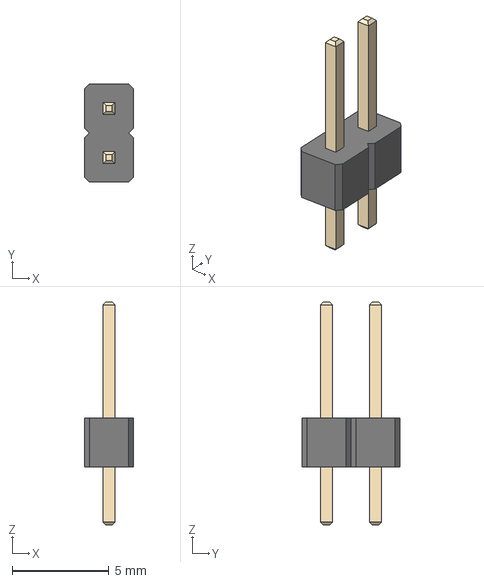
[picture p18: CAD file, 2026-11-08]
hardware/3d/PinHeader_1x02_P2.54mm_Vertical.step
2.54 x 5.08 x 11.5 mm
