adsdevdoo/retro535/hardware/3d/PinHeader_2x15_P2.54mm_Vertical.step

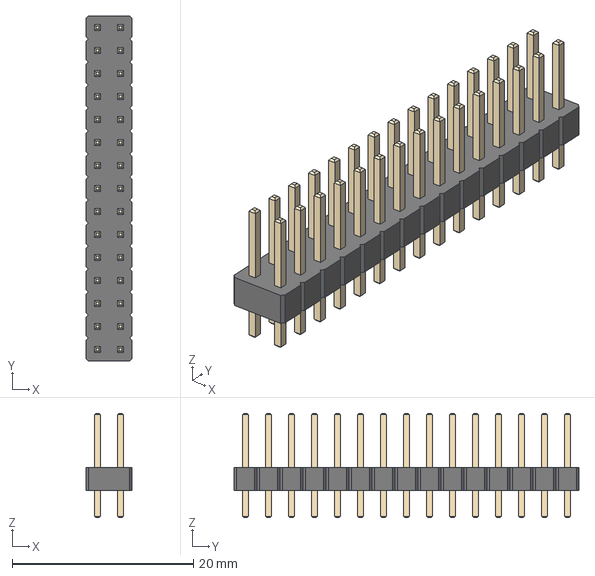
[picture p19: CAD file, 2026-11-08]
hardware/3d/PinHeader_2x15_P2.54mm_Vertical.step
5.08 x 38.1 x 11.5 mm
