adsdevdoo/retro535/hardware/3d/PinHeader_2x04_P2.54mm_Vertical.step

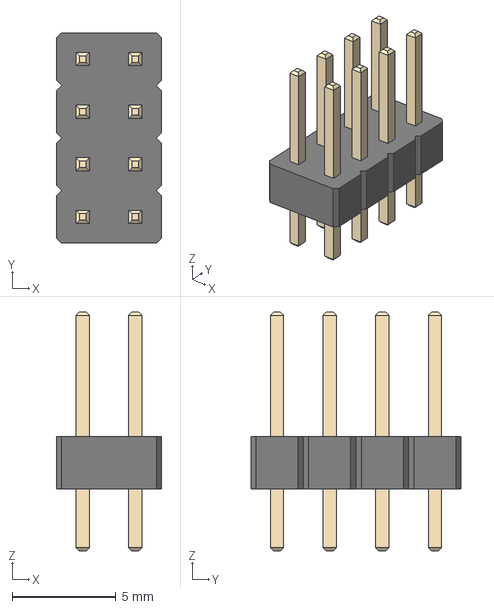
[picture p20: CAD file, 2026-11-08]
hardware/3d/PinHeader_2x04_P2.54mm_Vertical.step
5.08 x 10.2 x 11.5 mm
