adsdevdoo/retro535/hardware/3d/R_0805_2012Metric.step

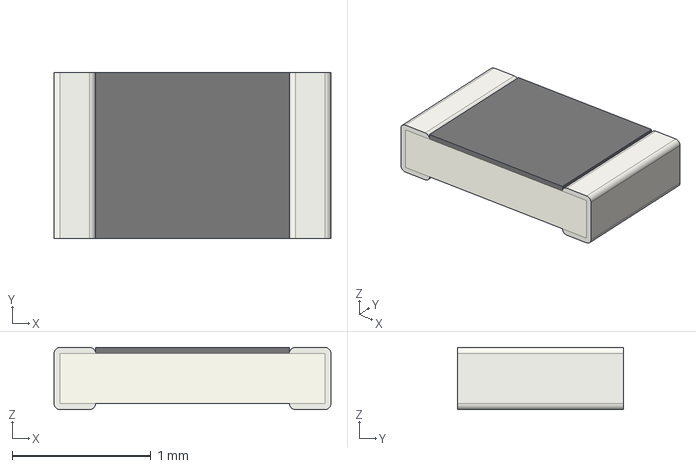
[picture p21: CAD file, 2026-11-08]
hardware/3d/R_0805_2012Metric.step
2.00 x 1.20 x 0.45 mm
