adsdevdoo/retro535/hardware/3d/LED_0805_2012Metric.step

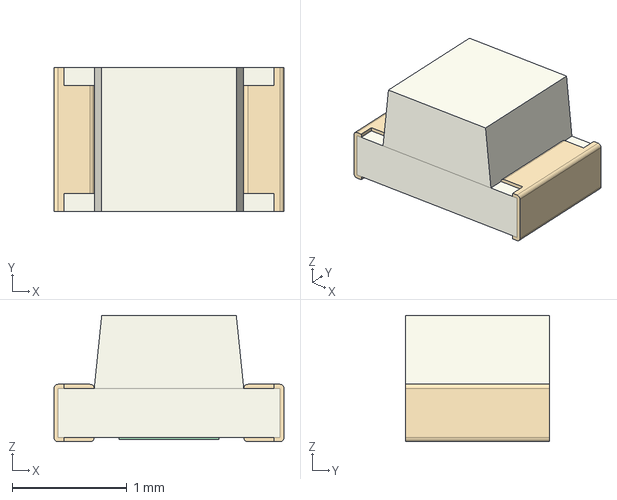
[picture p23: CAD file, 2026-11-08]
hardware/3d/LED_0805_2012Metric.step
2.00 x 1.25 x 1.10 mm
