adsdevdoo/retro535/hardware/3d/PLCC68_THT_70207015_illustrative.step

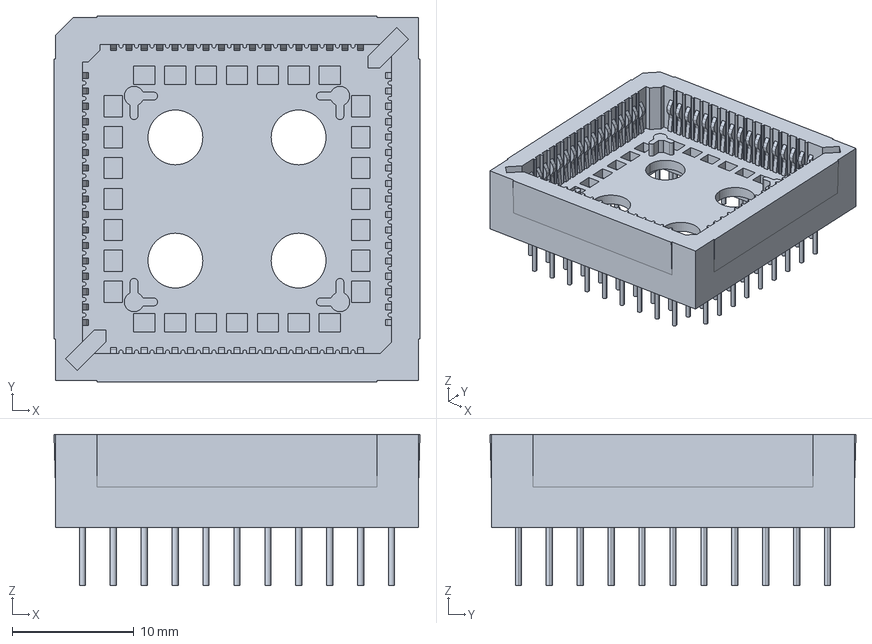
[picture p24: CAD file, 2026-11-08]
hardware/3d/PLCC68_THT_70207015_illustrative.step
30.1 x 30.1 x 12.4 mm
