adsdevdoo/retro535/hardware/3d/Crystal_HC49-U_Vertical.step

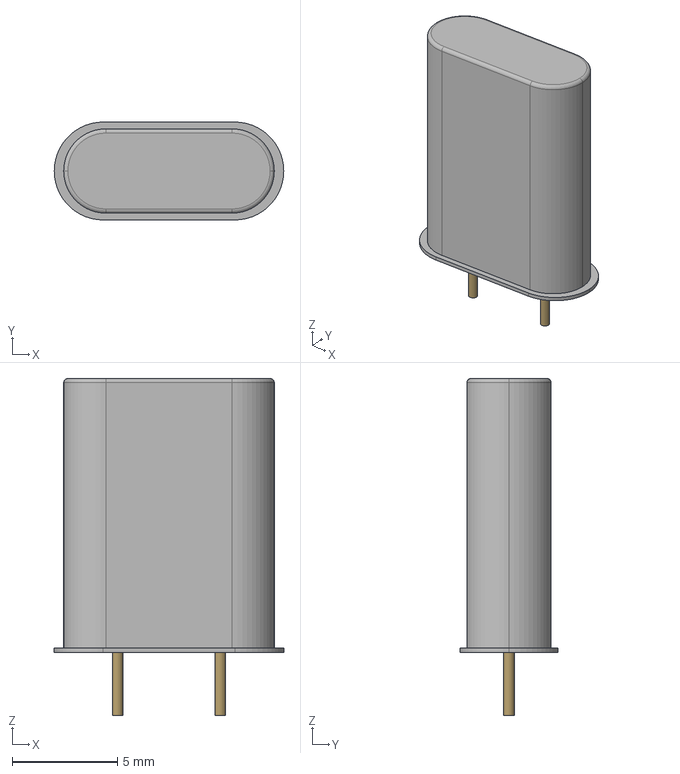
[picture p25: CAD file, 2026-11-08]
hardware/3d/Crystal_HC49-U_Vertical.step
10.9 x 4.65 x 16.0 mm
