adsdevdoo/retro535/hardware/3d/SSOP-28_5.3x10.2mm_P0.65mm.step

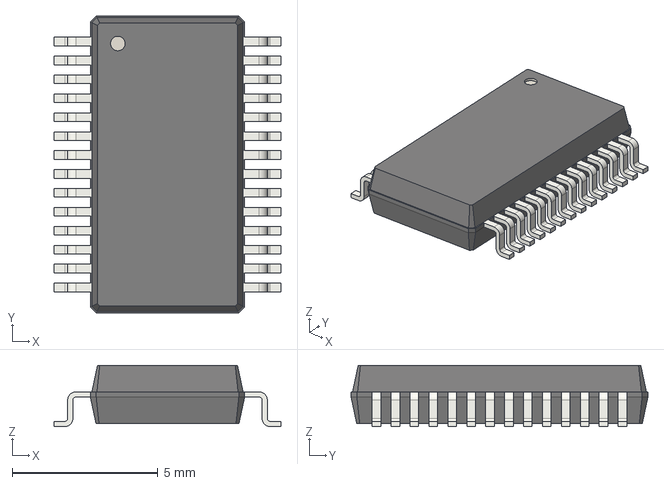
[picture p26: CAD file, 2026-11-08]
hardware/3d/SSOP-28_5.3x10.2mm_P0.65mm.step
7.80 x 10.2 x 2.10 mm
