adsdevdoo/retro535/(list of files, cad)

Other CAD files:
hardware/3d/HRO_TYPE-C-31-M-12_aligned.step
hardware/3d/L_0805_2012Metric.step
