adsdevdoo/retro535/docs/manufacturing.md

# Заказ прототипа в JLCPCB

Загружать **только** архив `fabrication/retro535-v1.0-jlcpcb.zip`.
Это заказ пустых PCB для самостоятельной пайки, не PCBA с установкой
компонентов. BOM содержит также редкий МК владельца, панели и устаревшую SRAM;
автоматическая комплектация JLCPCB этим выпуском не подготовлена.

| Параметр заказа | Значение |
|---|---|
| Габарит по центру Edge.Cuts | 100 × 80 мм |
| Материал | FR-4 |
| Слои | 2 |
| Толщина | 1,6 мм |
| Медь | 1 oz |
| Маска | Зелёная |
| Шелкография | Белая, с обеих сторон |
| Покрытие | ENIG предпочтительно для мелкого USB-C; lead-free HASL допустим |
| Переходные отверстия | Сквозные, минимальное сверло 0,30 мм, tented |
| Особые технологии | Нет blind/buried via, контролируемого импеданса, castellated holes |
| Крепёж | Четыре NPTH Ø3,2 мм, центры (4;4), (96;4), (4;76), (96;76) мм |

Размер 100 × 80 мм — номинал; изготовитель задаёт собственный допуск фрезеровки.
На верхней кромке предусмотрен неглубокий вырез под USB-C: 11 мм шириной,
0,81 мм глубиной, внутренние скругления R0,5. Он задаёт рекомендованное HRO
расстояние 5,79 мм от оси позиционирующих отверстий до края PCB и позволяет
устью разъёма выступать за плату. Внешние габариты остаются 100 × 80 мм.
Минимальная дорожка 0,18 мм, проектный зазор сетей 0,20 мм, глобальный
минимум 0,18 мм, медь до края ≥0,30 мм. Минимальный текст 1,0 мм,
штрих 0,15 мм, зазор шелкографии 0,15 мм. Эти значения сверены с
[опубликованными возможностями JLCPCB](https://jlcpcb.com/capabilities/pcb-capabilities)
8 ноября 2026 г. Это не подтверждение заказа фабрикой.

Архив содержит 7 Gerber: верхняя/нижняя медь, маска, шелкография и один
замкнутый контур. Два Excellon: **PTH** и **NPTH**; оба нужны.
У USB-C есть четыре металлизированных овальных отверстия корпуса,
а также два непроводящих позиционирующих отверстия. Карты сверления PDF
лежат отдельно и не должны заменять `.drl`.
Передние пазы USB-C — 0,6 × 1,4 мм; задние — 0,6 × 1,7 мм.
Они сверены с чертежом HRO TYPE-C-31-M-12 от 2020-12-08; передняя пара
увеличена относительно старой системной библиотеки KiCad. Сохранены
удлинённые SMD-площадки KiCad для пайки вручную (перекрытие зоны контакта
с рекомендованным рисунком есть); их размер не копируется из 3D-модели.

После загрузки в просмотрщике фабрики проверить: 100 × 80 мм, ровно два
слоя меди, обе маски и шелкографии, четыре крепёжных отверстия, 68 отверстий
панели МК, обе DIP-панели, четыре овальных PTH USB. Верх и низ не зеркалить
вручную: координаты уже согласованы. Размер векторного штриха Edge.Cuts
0,05 мм не увеличивает номинальный размер фрезеровки; контур — его центр.

Заказывать сначала небольшую партию **прототипов**. ERC/DRC, программная
симуляция и просмотр Gerber не доказывают работу в железе. Требуется
первое включение по `bring-up.md`; особенно питание TP3 >4,75 В под
нагрузкой, ориентация панелей и внешний программатор SST39SF010A.
Проверка DFM самим JLCPCB и физические испытания пока не выполнялись.
