adsdevdoo/retro535/docs/schematic.pdf

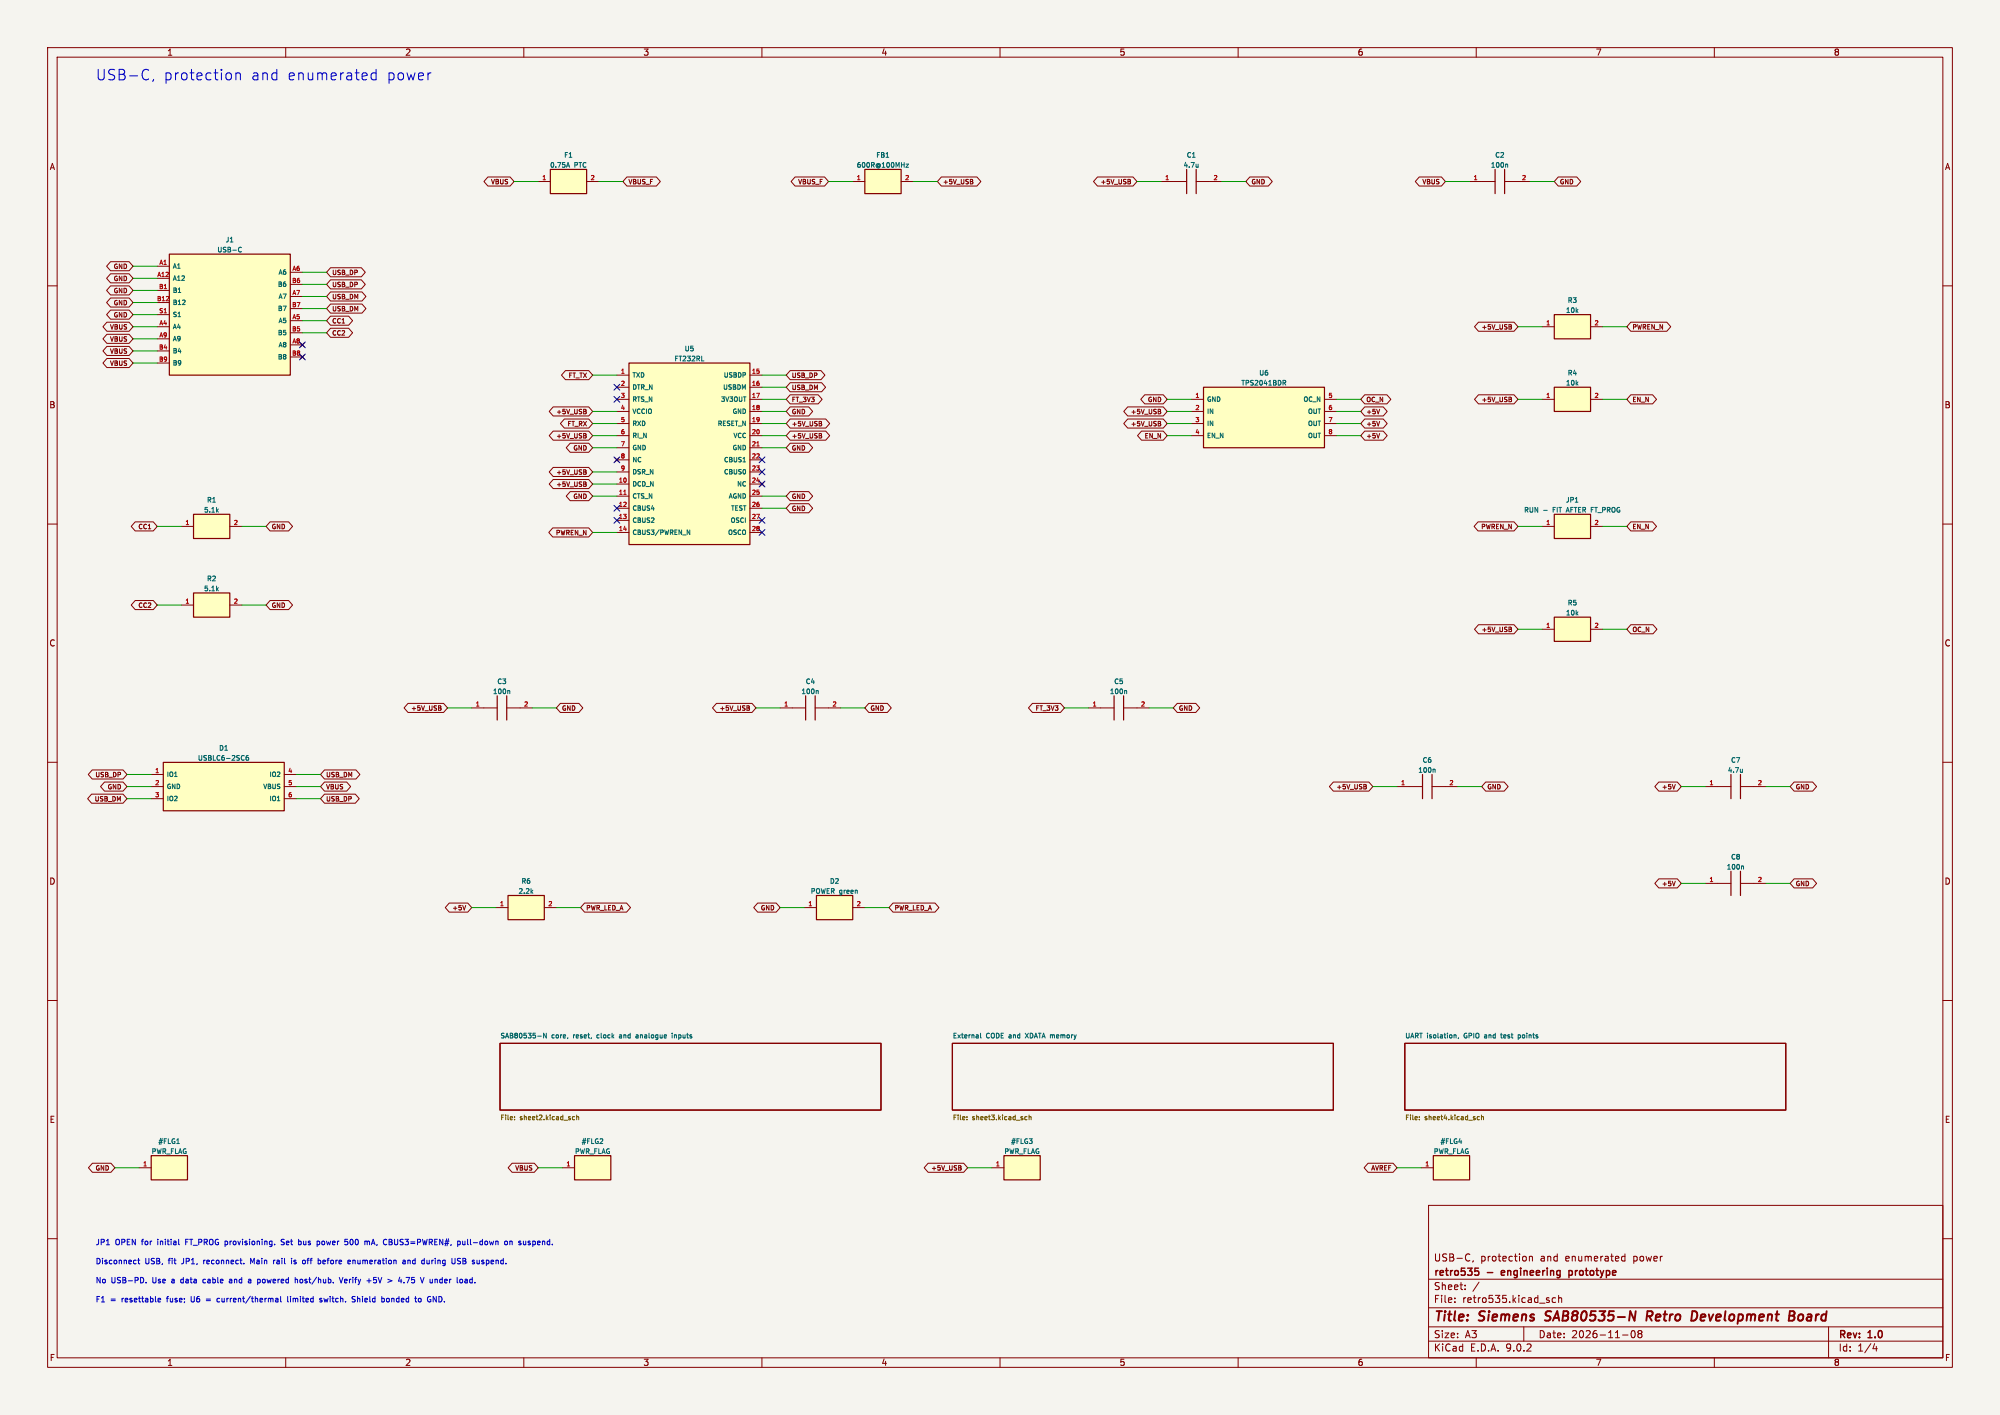
[picture p27: page 1]

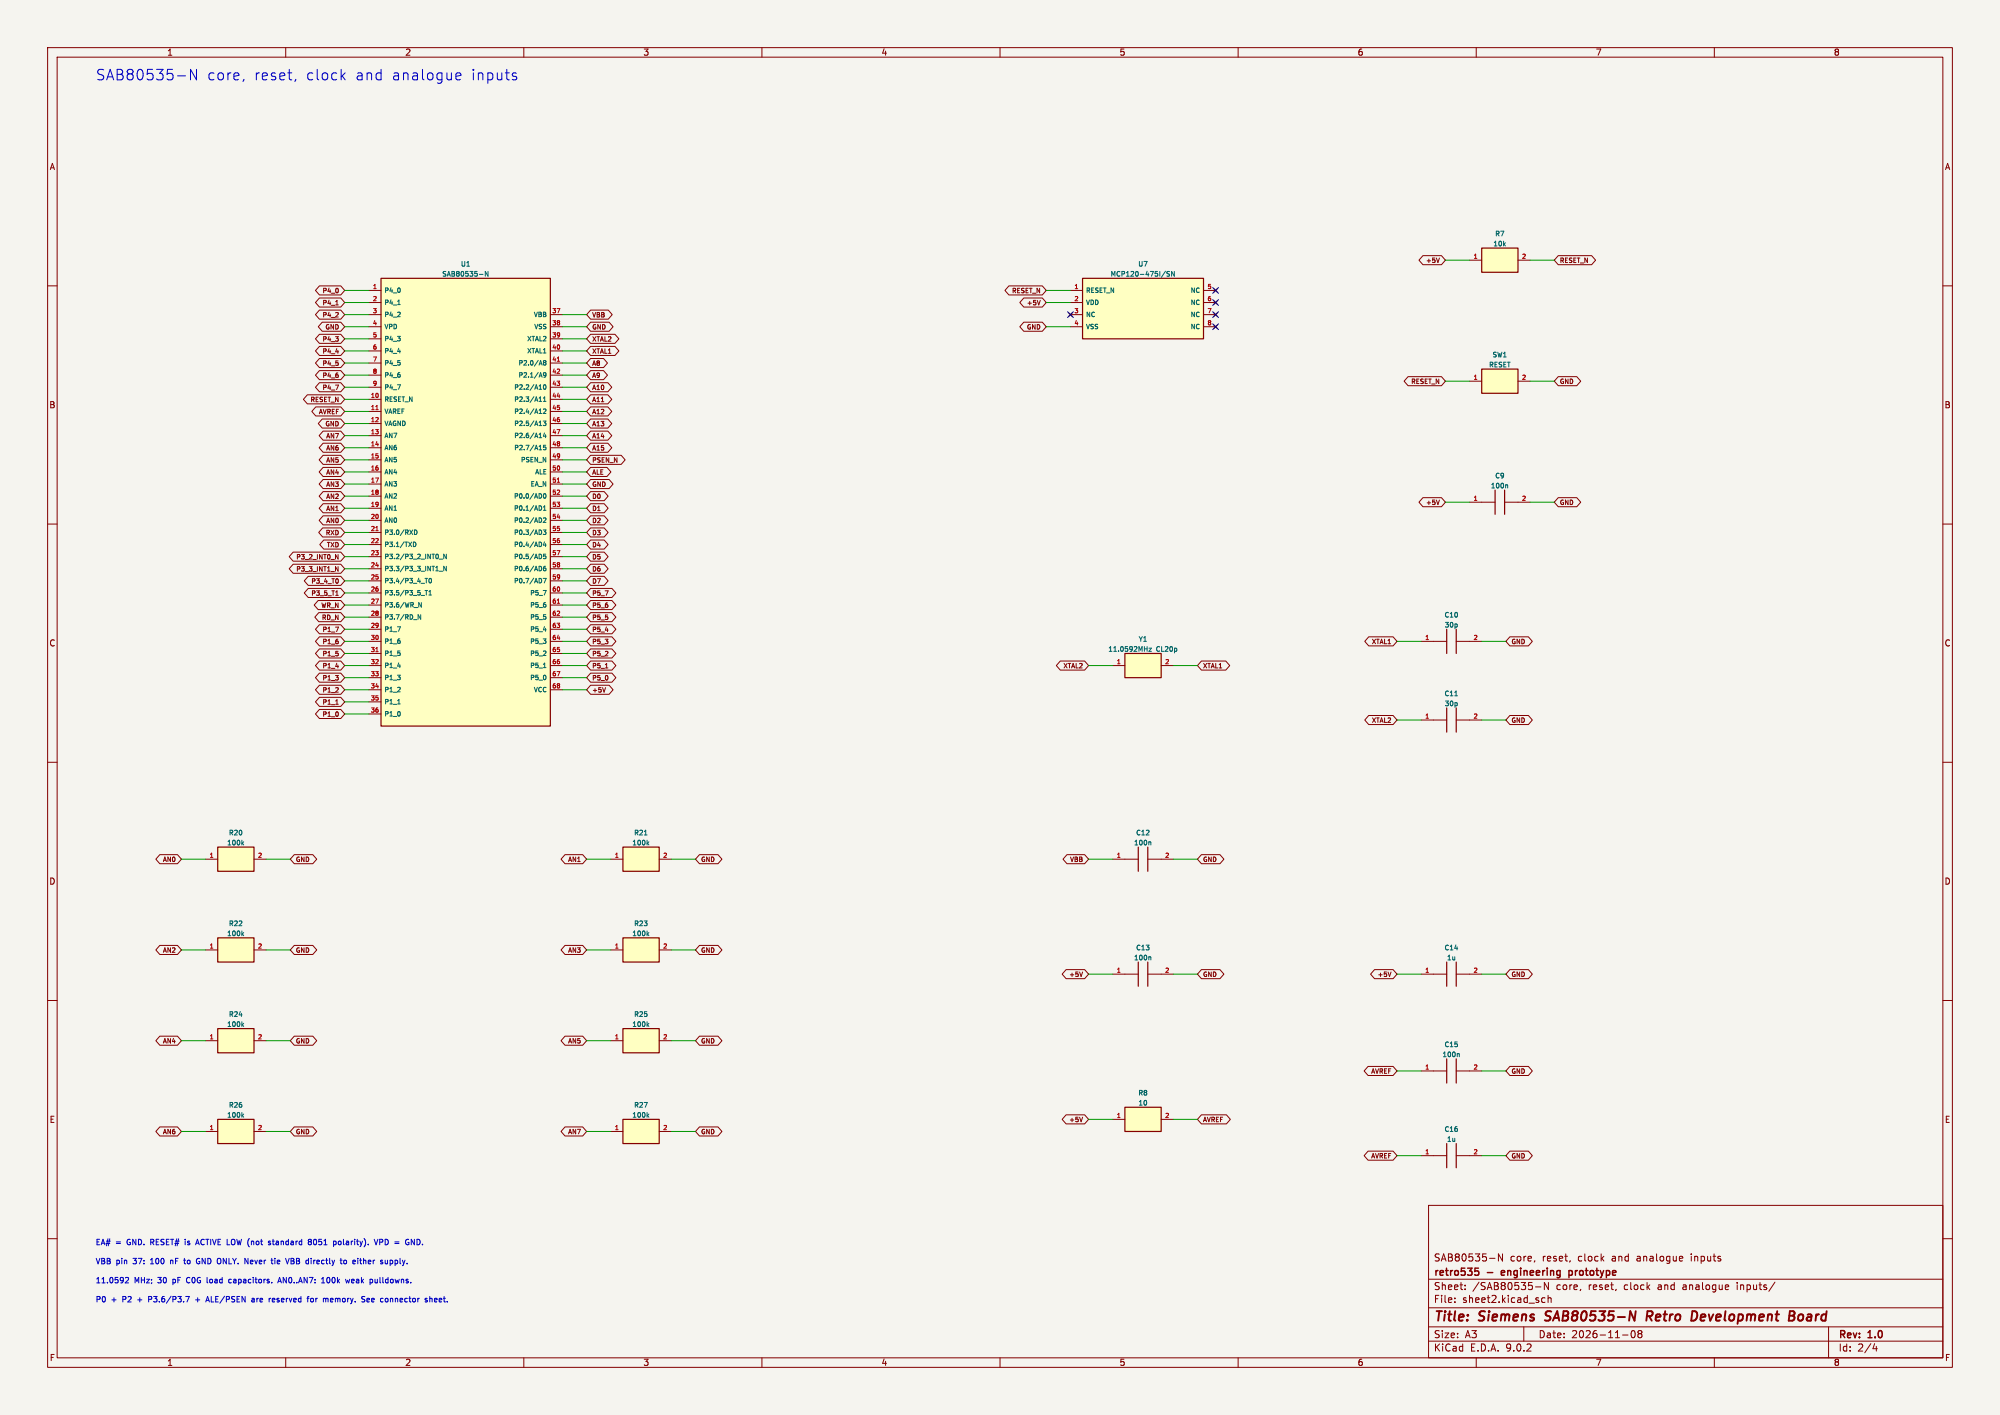
[picture p28: page 2]

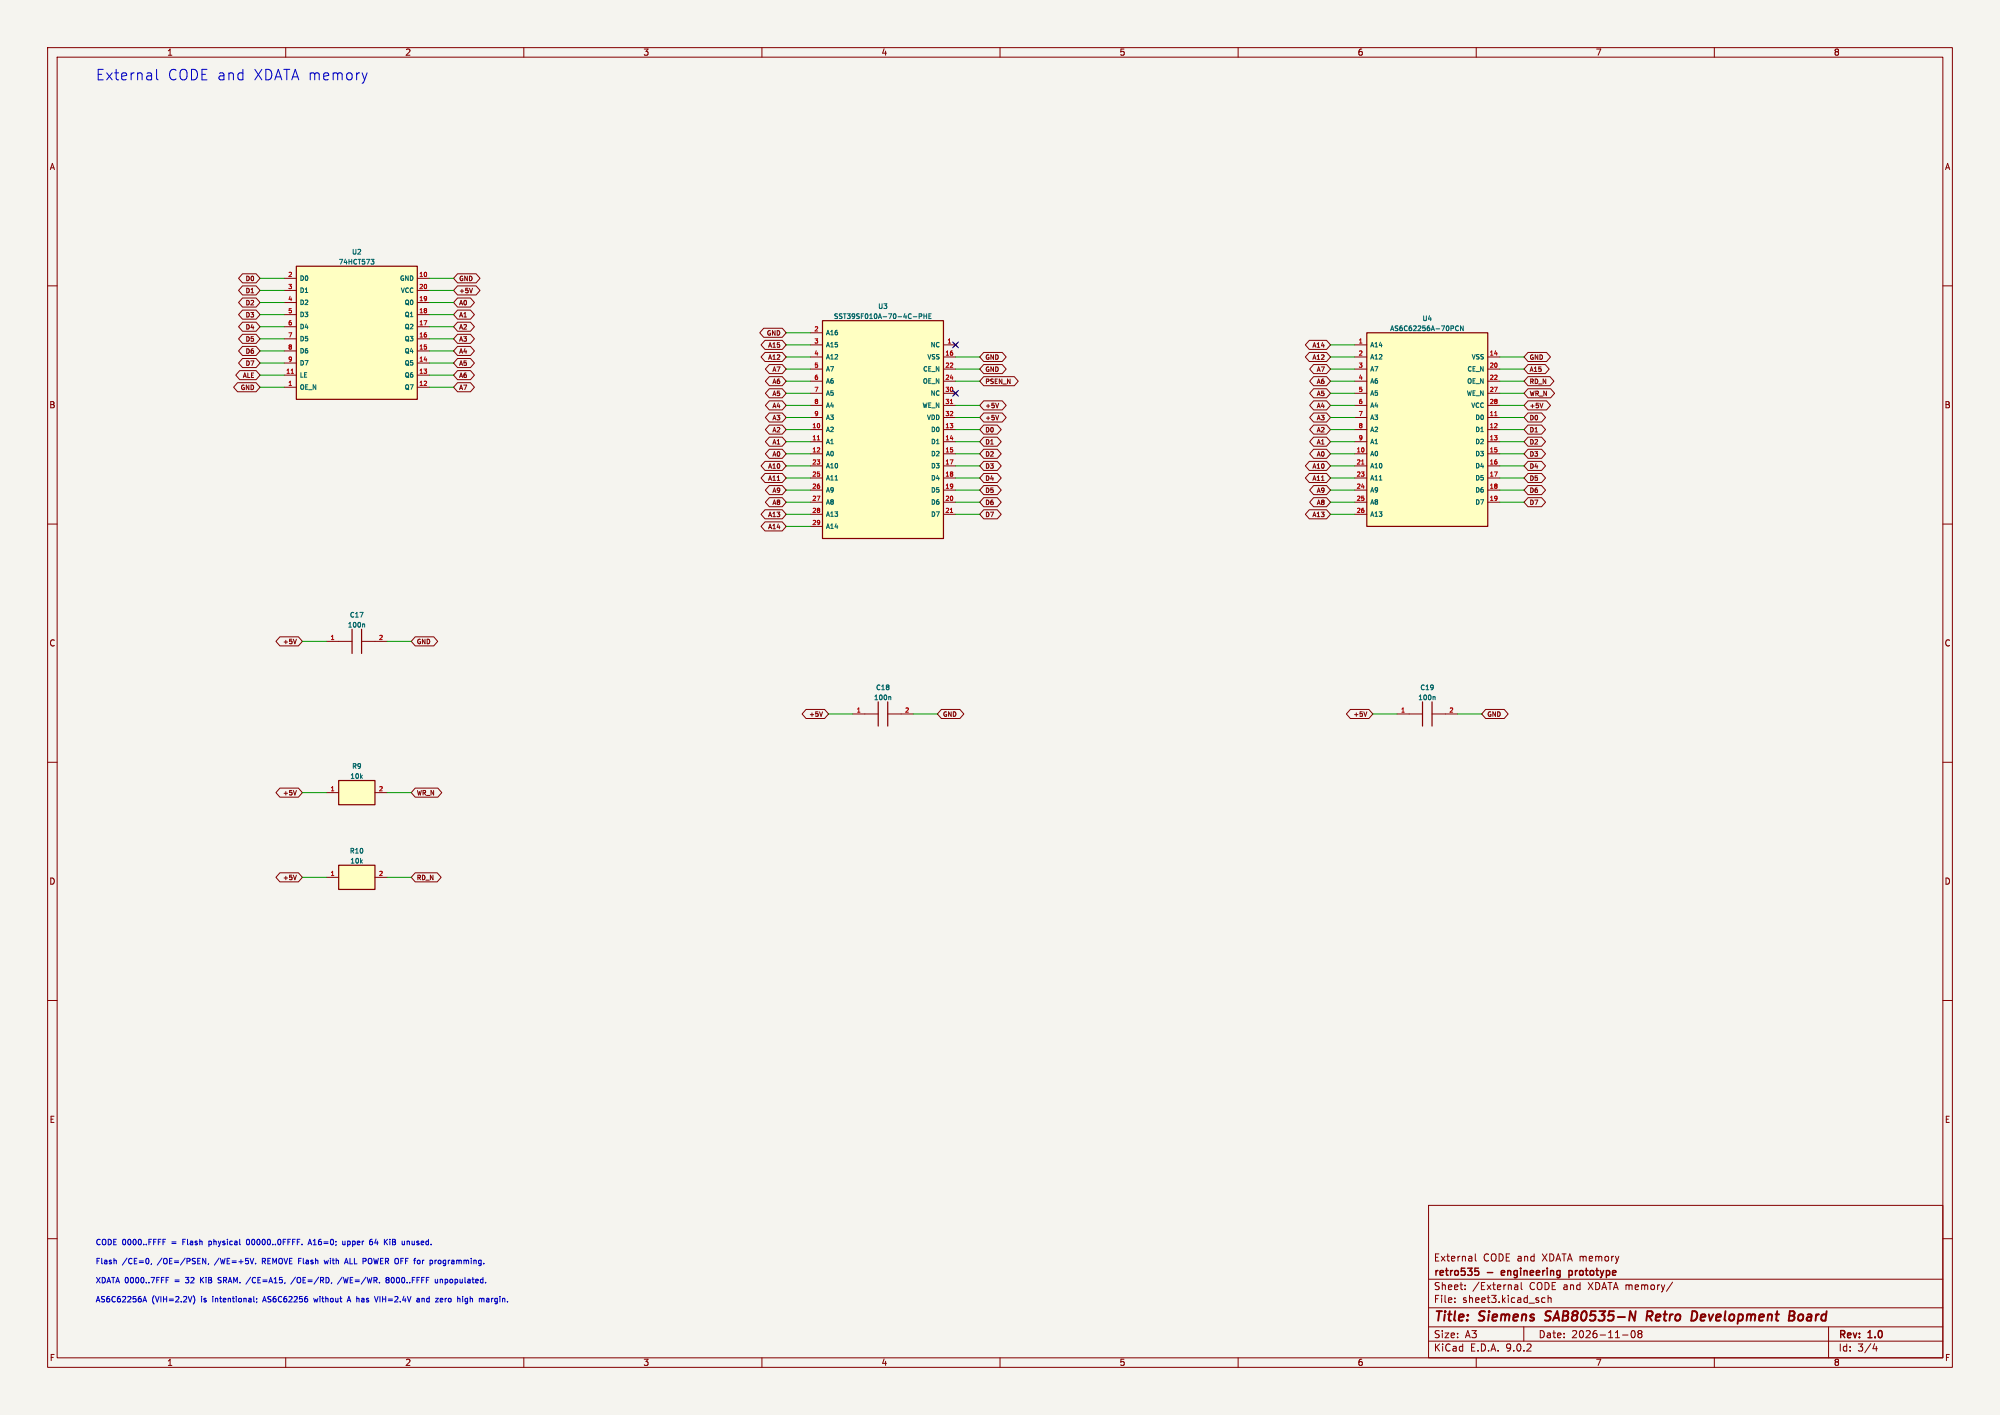
[picture p29: page 3]

D2 External CODE and XDATA memory

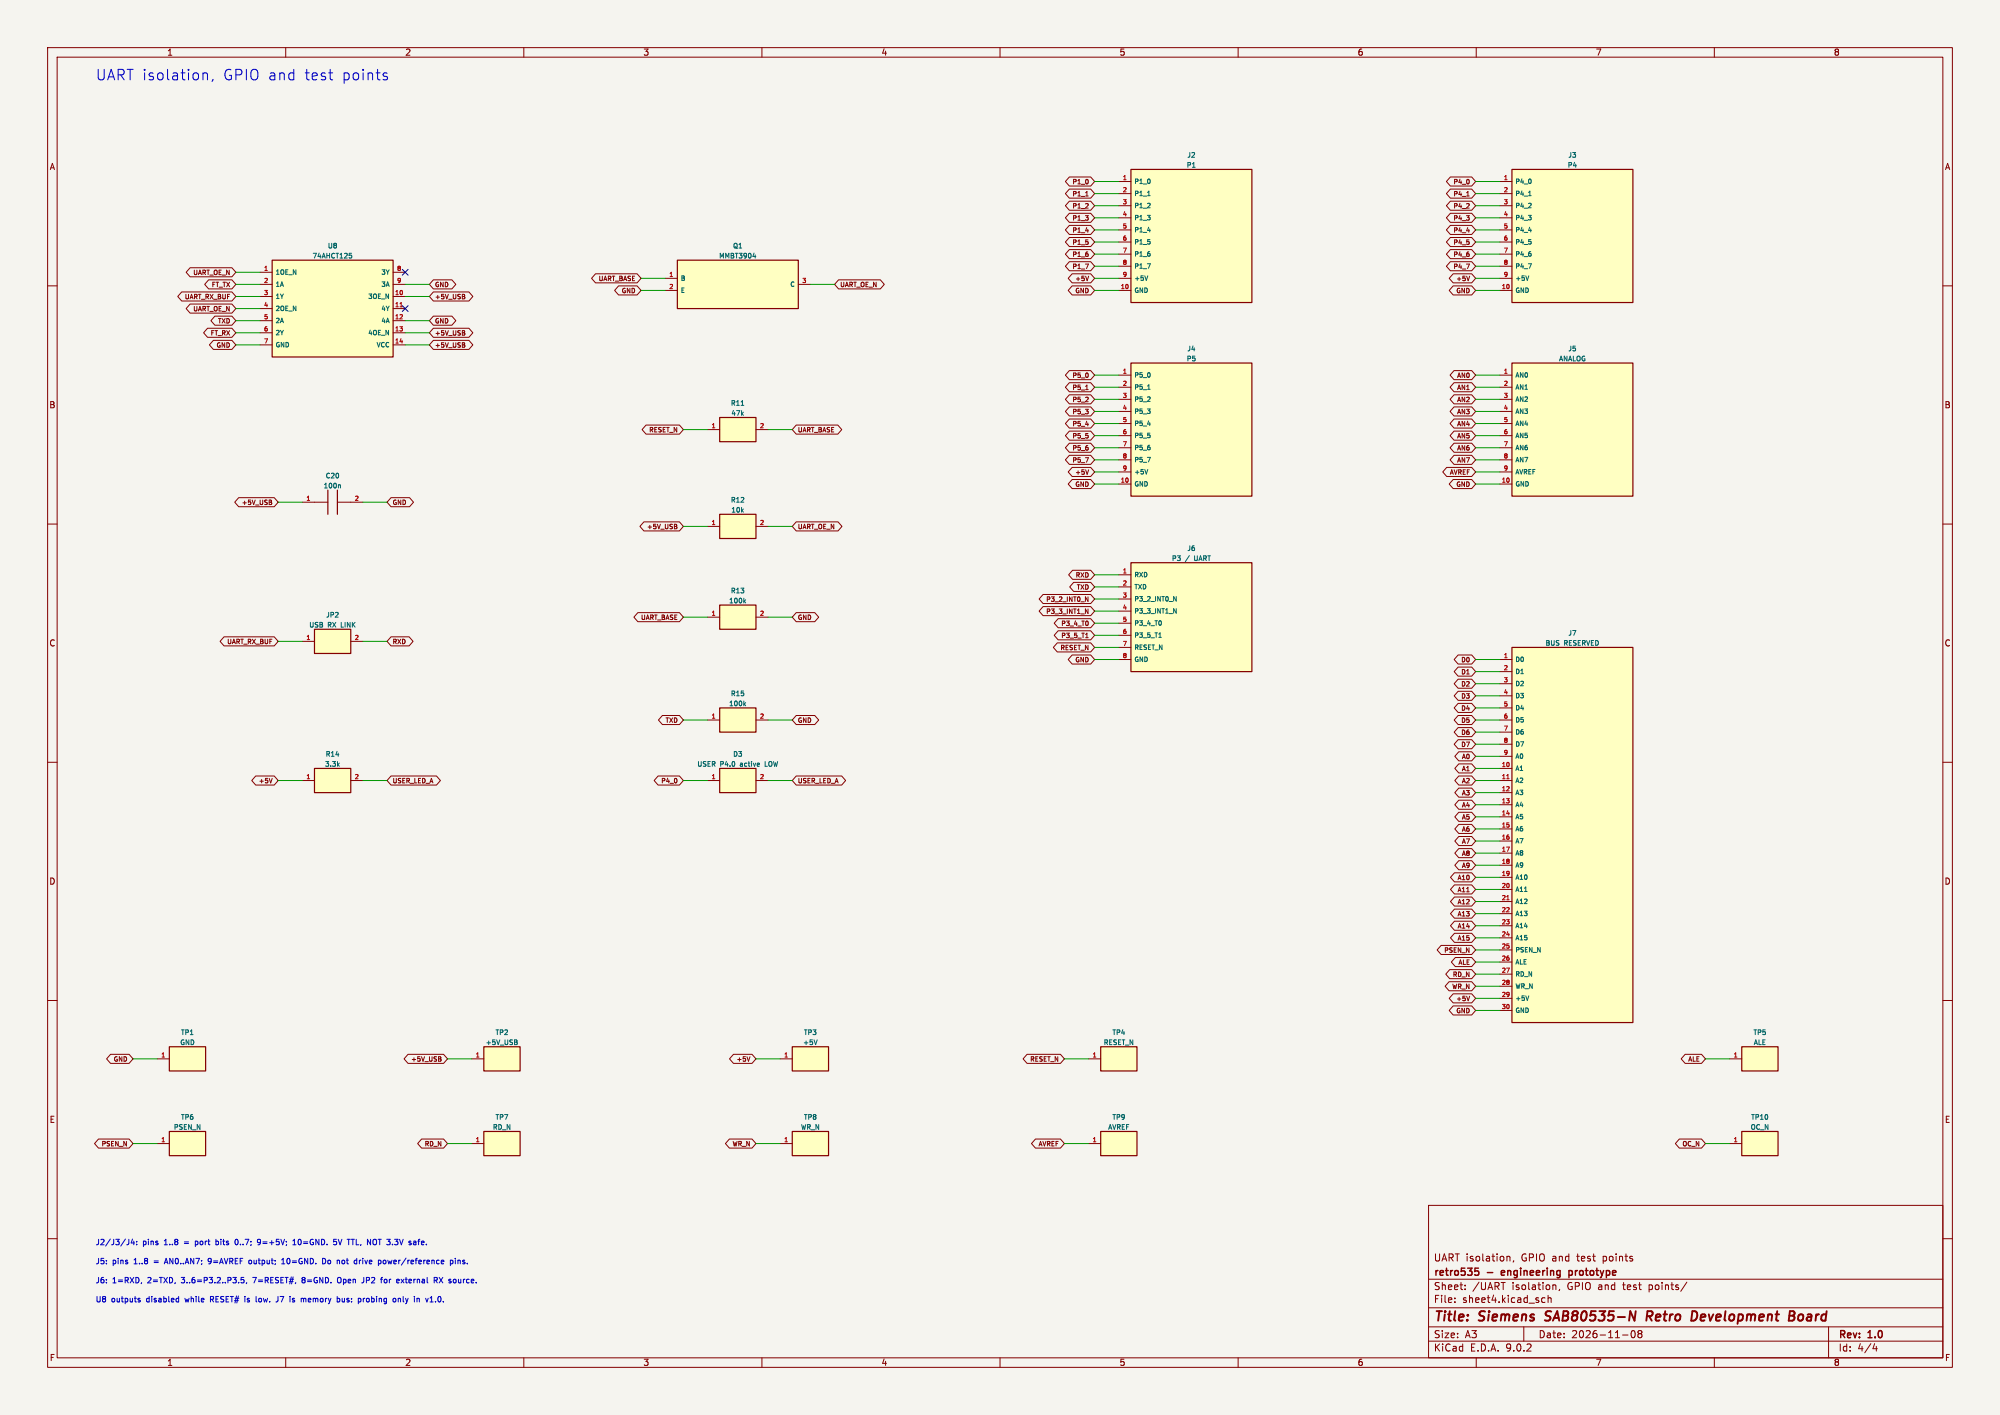
[picture p30: page 4]
