adsdevdoo/retro535/(list of files, drawings)

Other design files:
reports/pcb-geometry.json
