adsdevdoo/retro535/hardware/retro535.kicad_pcb

## KiCad design hardware/retro535.kicad_pcb (2026-11-08)

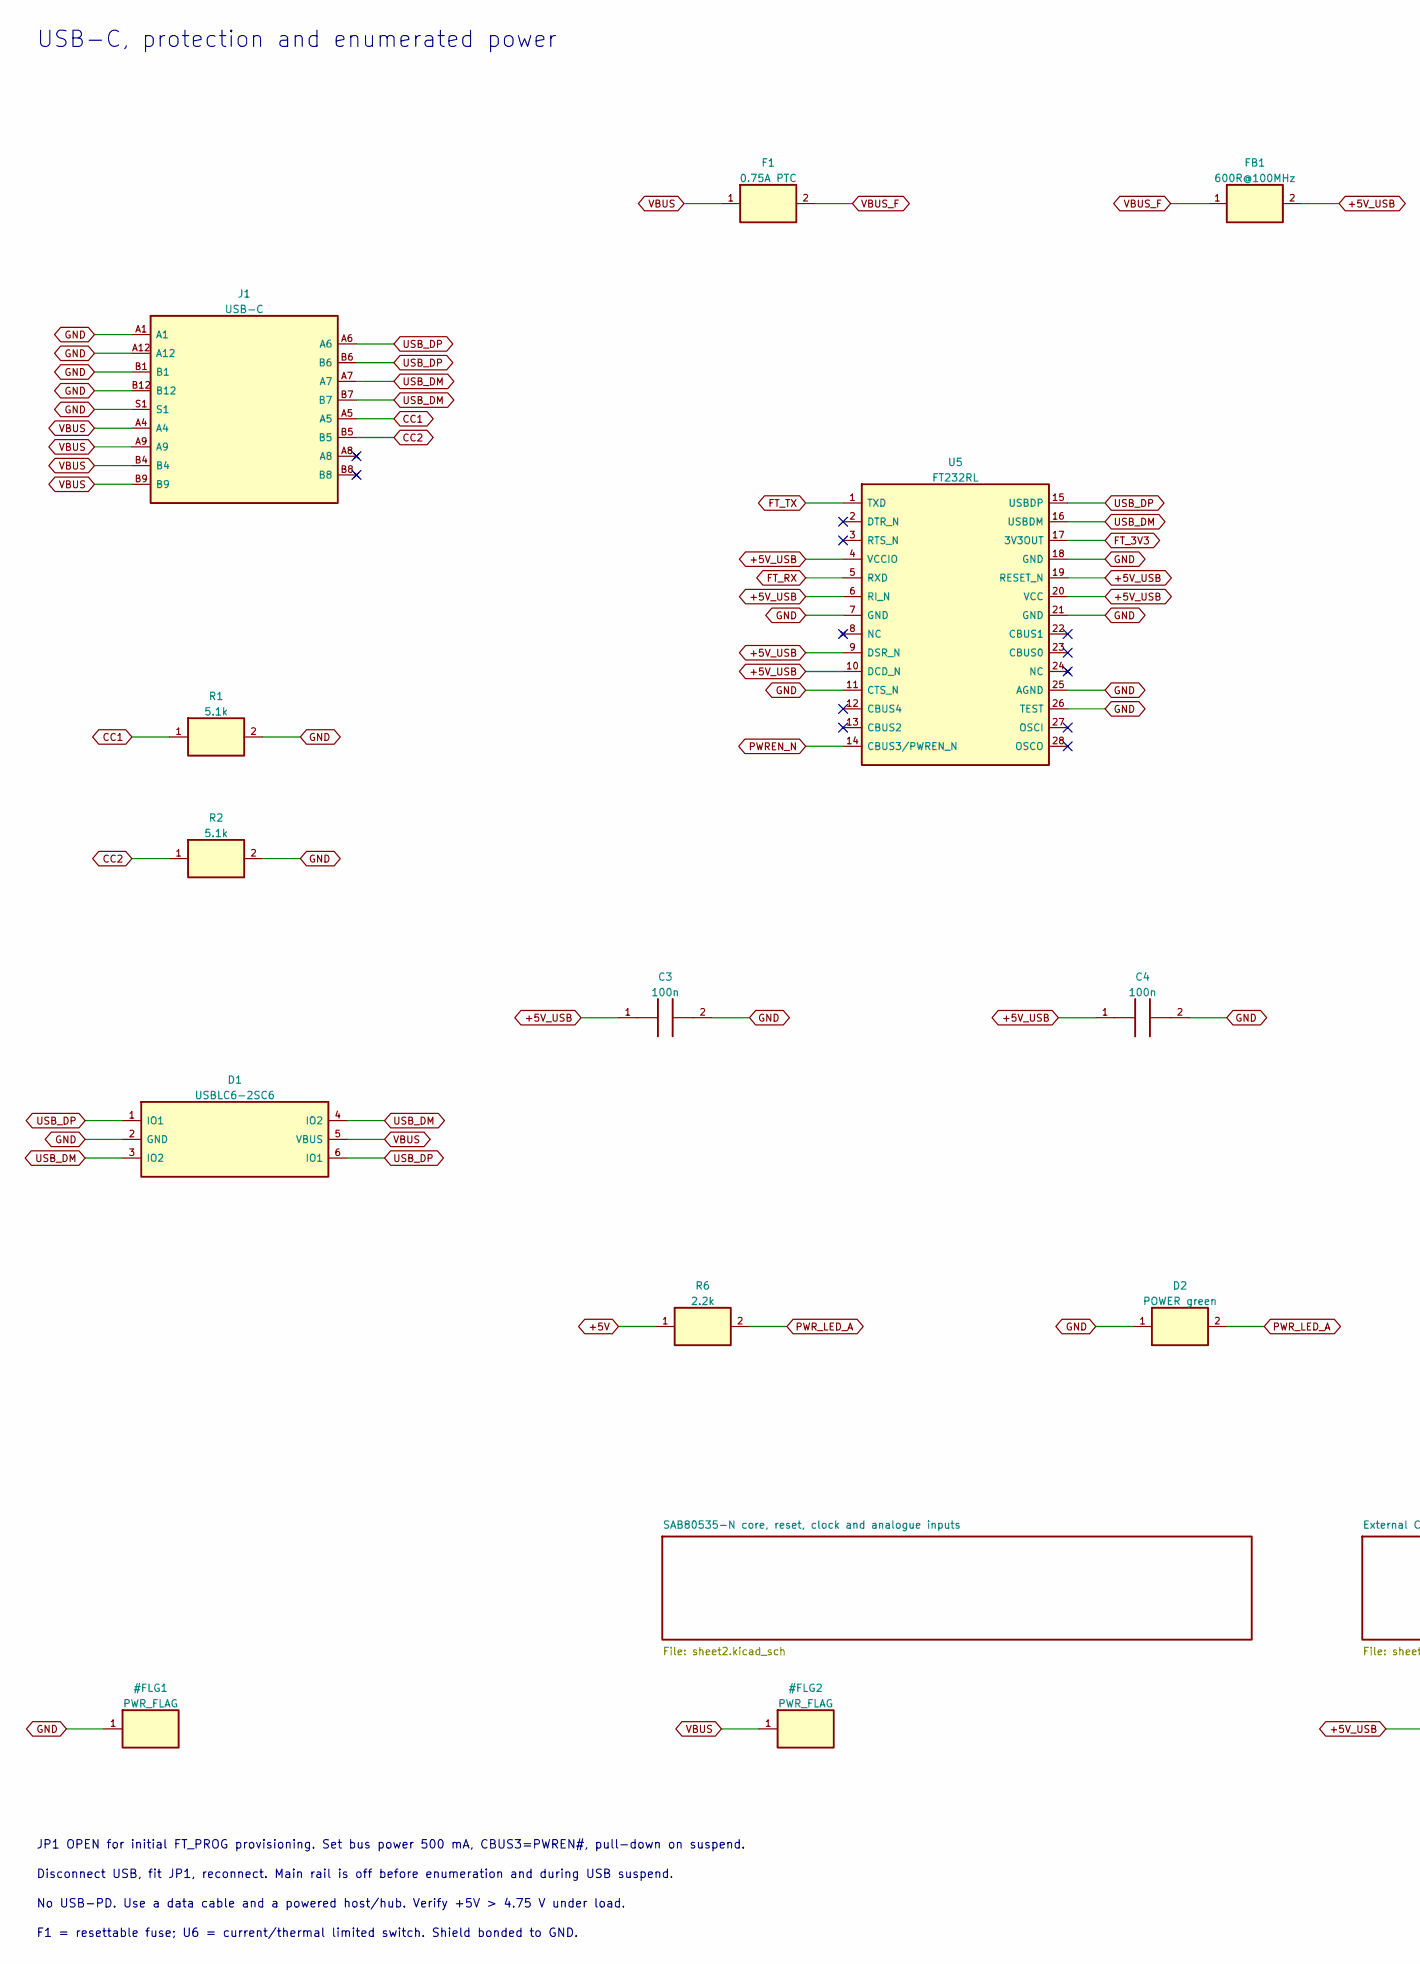
[picture p31: schematic retro535.kicad_sch, Siemens SAB80535-N Retro Development Board, part in row 1, column 1]

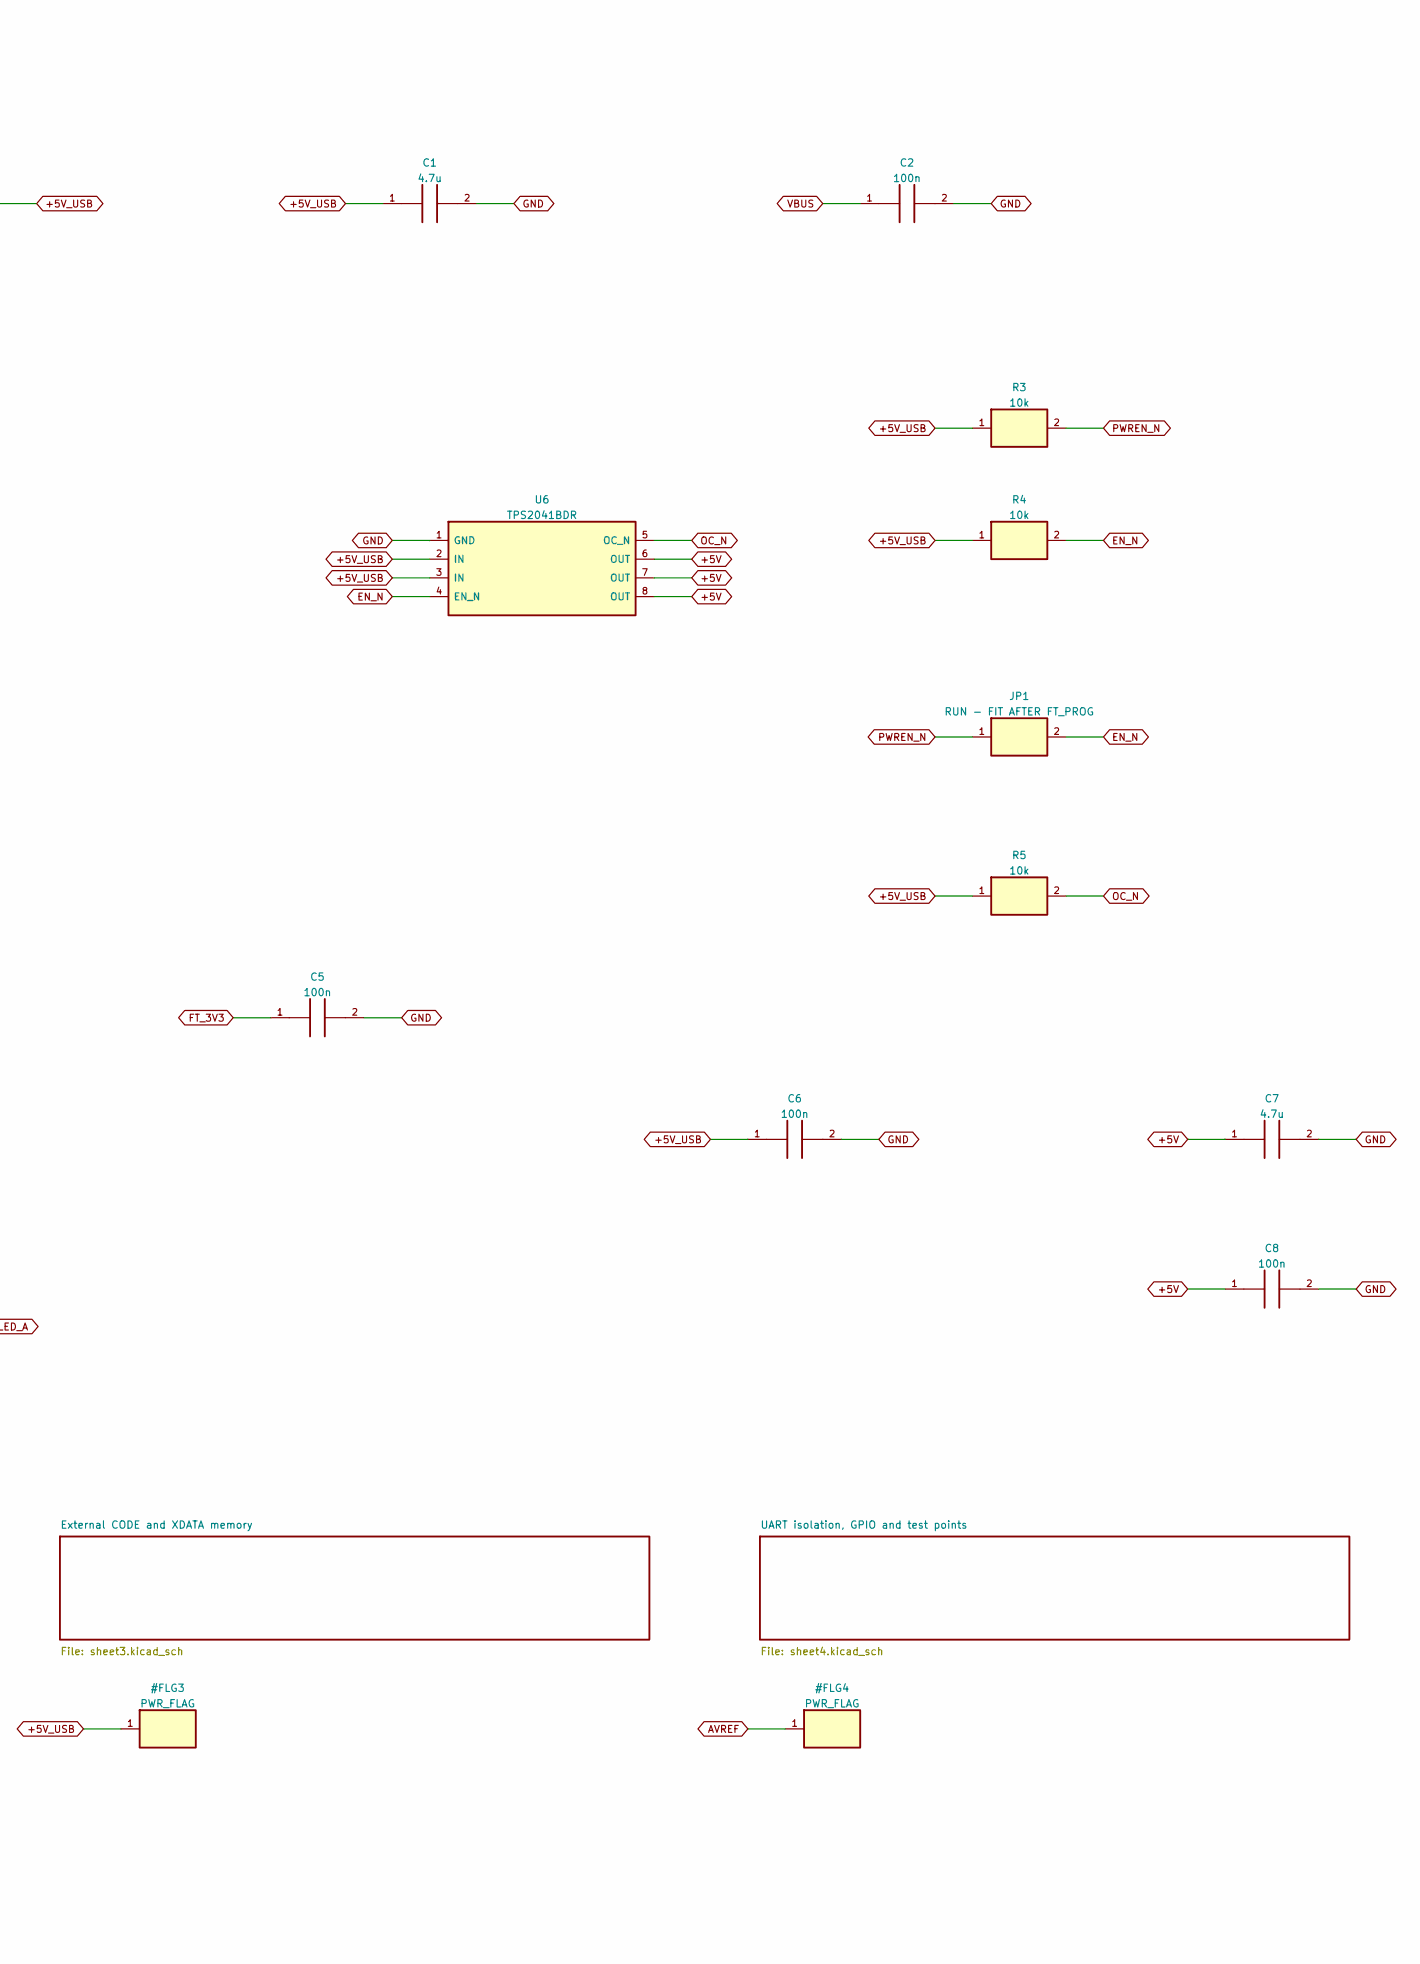
[picture p32: schematic retro535.kicad_sch, Siemens SAB80535-N Retro Development Board, part in row 1, column 2]

Parts:
C1, C7: 4.7u; C_0805_2012Metric_Pad1.18x1.45mm_HandSolder; MPN GRM21BR61C475KA73L
C2, C3, C4, C5, C6, C8: 100n; C_0805_2012Metric_Pad1.18x1.45mm_HandSolder; MPN GRM21BR71H104KA01L
D1: USBLC6-2SC6; SOT-23-6; MPN USBLC6-2SC6
D2: POWER green; LED_0805_2012Metric_Pad1.15x1.40mm_HandSolder; MPN LTST-C170KGKT
F1: 0.75A PTC; Fuse_1812_4532Metric; MPN MF-MSMF075-2
FB1: 600R@100MHz; L_0805_2012Metric_Pad1.15x1.40mm_HandSolder; MPN BLM21PG601SN1D
J1: USB-C; USB_C_Receptacle_HRO_TYPE-C-31-M-12; MPN TYPE-C-31-M-12
JP1: RUN - FIT AFTER FT_PROG; PinHeader_1x02_P2.54mm_Vertical; MPN M20-9990245
R1, R2: 5.1k; R_0805_2012Metric_Pad1.20x1.40mm_HandSolder; MPN RC0805FR-075K1L
R3, R4, R5: 10k; R_0805_2012Metric_Pad1.20x1.40mm_HandSolder; MPN RC0805FR-0710KL
R6: 2.2k; R_0805_2012Metric_Pad1.20x1.40mm_HandSolder; MPN RC0805FR-072K2L
U5: FT232RL; SSOP-28_5.3x10.2mm_P0.65mm; MPN FT232RL
U6: TPS2041BDR; SOIC-8_3.9x4.9mm_P1.27mm; MPN TPS2041BDR

Connections:
+5V: C7.1, C8.1, R6.1, U6.6 (OUT), U6.7 (OUT), U6.8 (OUT); also elsewhere on the board
+5V_USB: C1.1, C3.1, C4.1, C6.1, FB1.2, R3.1, R4.1, R5.1, U5.4 (VCCIO), U5.6 (RI_N), U5.9 (DSR_N), U5.10 (DCD_N), U5.19 (RESET_N), U5.20 (VCC), U6.2 (IN), U6.3 (IN); also elsewhere on the board
CC1: J1.A5, R1.1
CC2: J1.B5, R2.1
EN_N: JP1.2, R4.2, U6.4 (EN_N)
FT_3V3: C5.1, U5.17 (3V3OUT)
FT_RX: U5.5 (RXD); also elsewhere on the board
FT_TX: U5.1 (TXD); also elsewhere on the board
GND: C1.2, C2.2, C3.2, C4.2, C5.2, C6.2, C7.2, C8.2, D1.2 (GND), D2.1, J1.A1, J1.A12, J1.B1, J1.B12, J1.S1, R1.2, R2.2, U5.7 (GND), U5.11 (CTS_N), U5.18 (GND), U5.21 (GND), U5.25 (AGND), U5.26 (TEST), U6.1 (GND); also elsewhere on the board
OC_N: R5.2, U6.5 (OC_N); also elsewhere on the board
PWREN_N: JP1.1, R3.2, U5.14 (CBUS3/PWREN_N)
PWR_LED_A: D2.2, R6.2
USB_DM: D1.3 (IO2), D1.4 (IO2), J1.A7, J1.B7, U5.16 (USBDM)
USB_DP: D1.1 (IO1), D1.6 (IO1), J1.A6, J1.B6, U5.15 (USBDP)
VBUS: C2.1, D1.5 (VBUS), F1.1, J1.A4, J1.A9, J1.B4, J1.B9
VBUS_F: F1.2, FB1.1

Notes on the sheet:
USB-C, protection and enumerated power
JP1 OPEN for initial FT_PROG provisioning. Set bus power 500 mA, CBUS3=PWREN#, pull-down on suspend.
Disconnect USB, fit JP1, reconnect. Main rail is off before enumeration and during USB suspend.
No USB-PD. Use a data cable and a powered host/hub. Verify +5V > 4.75 V under load.
F1 = resettable fuse; U6 = current/thermal limited switch. Shield bonded to GND.

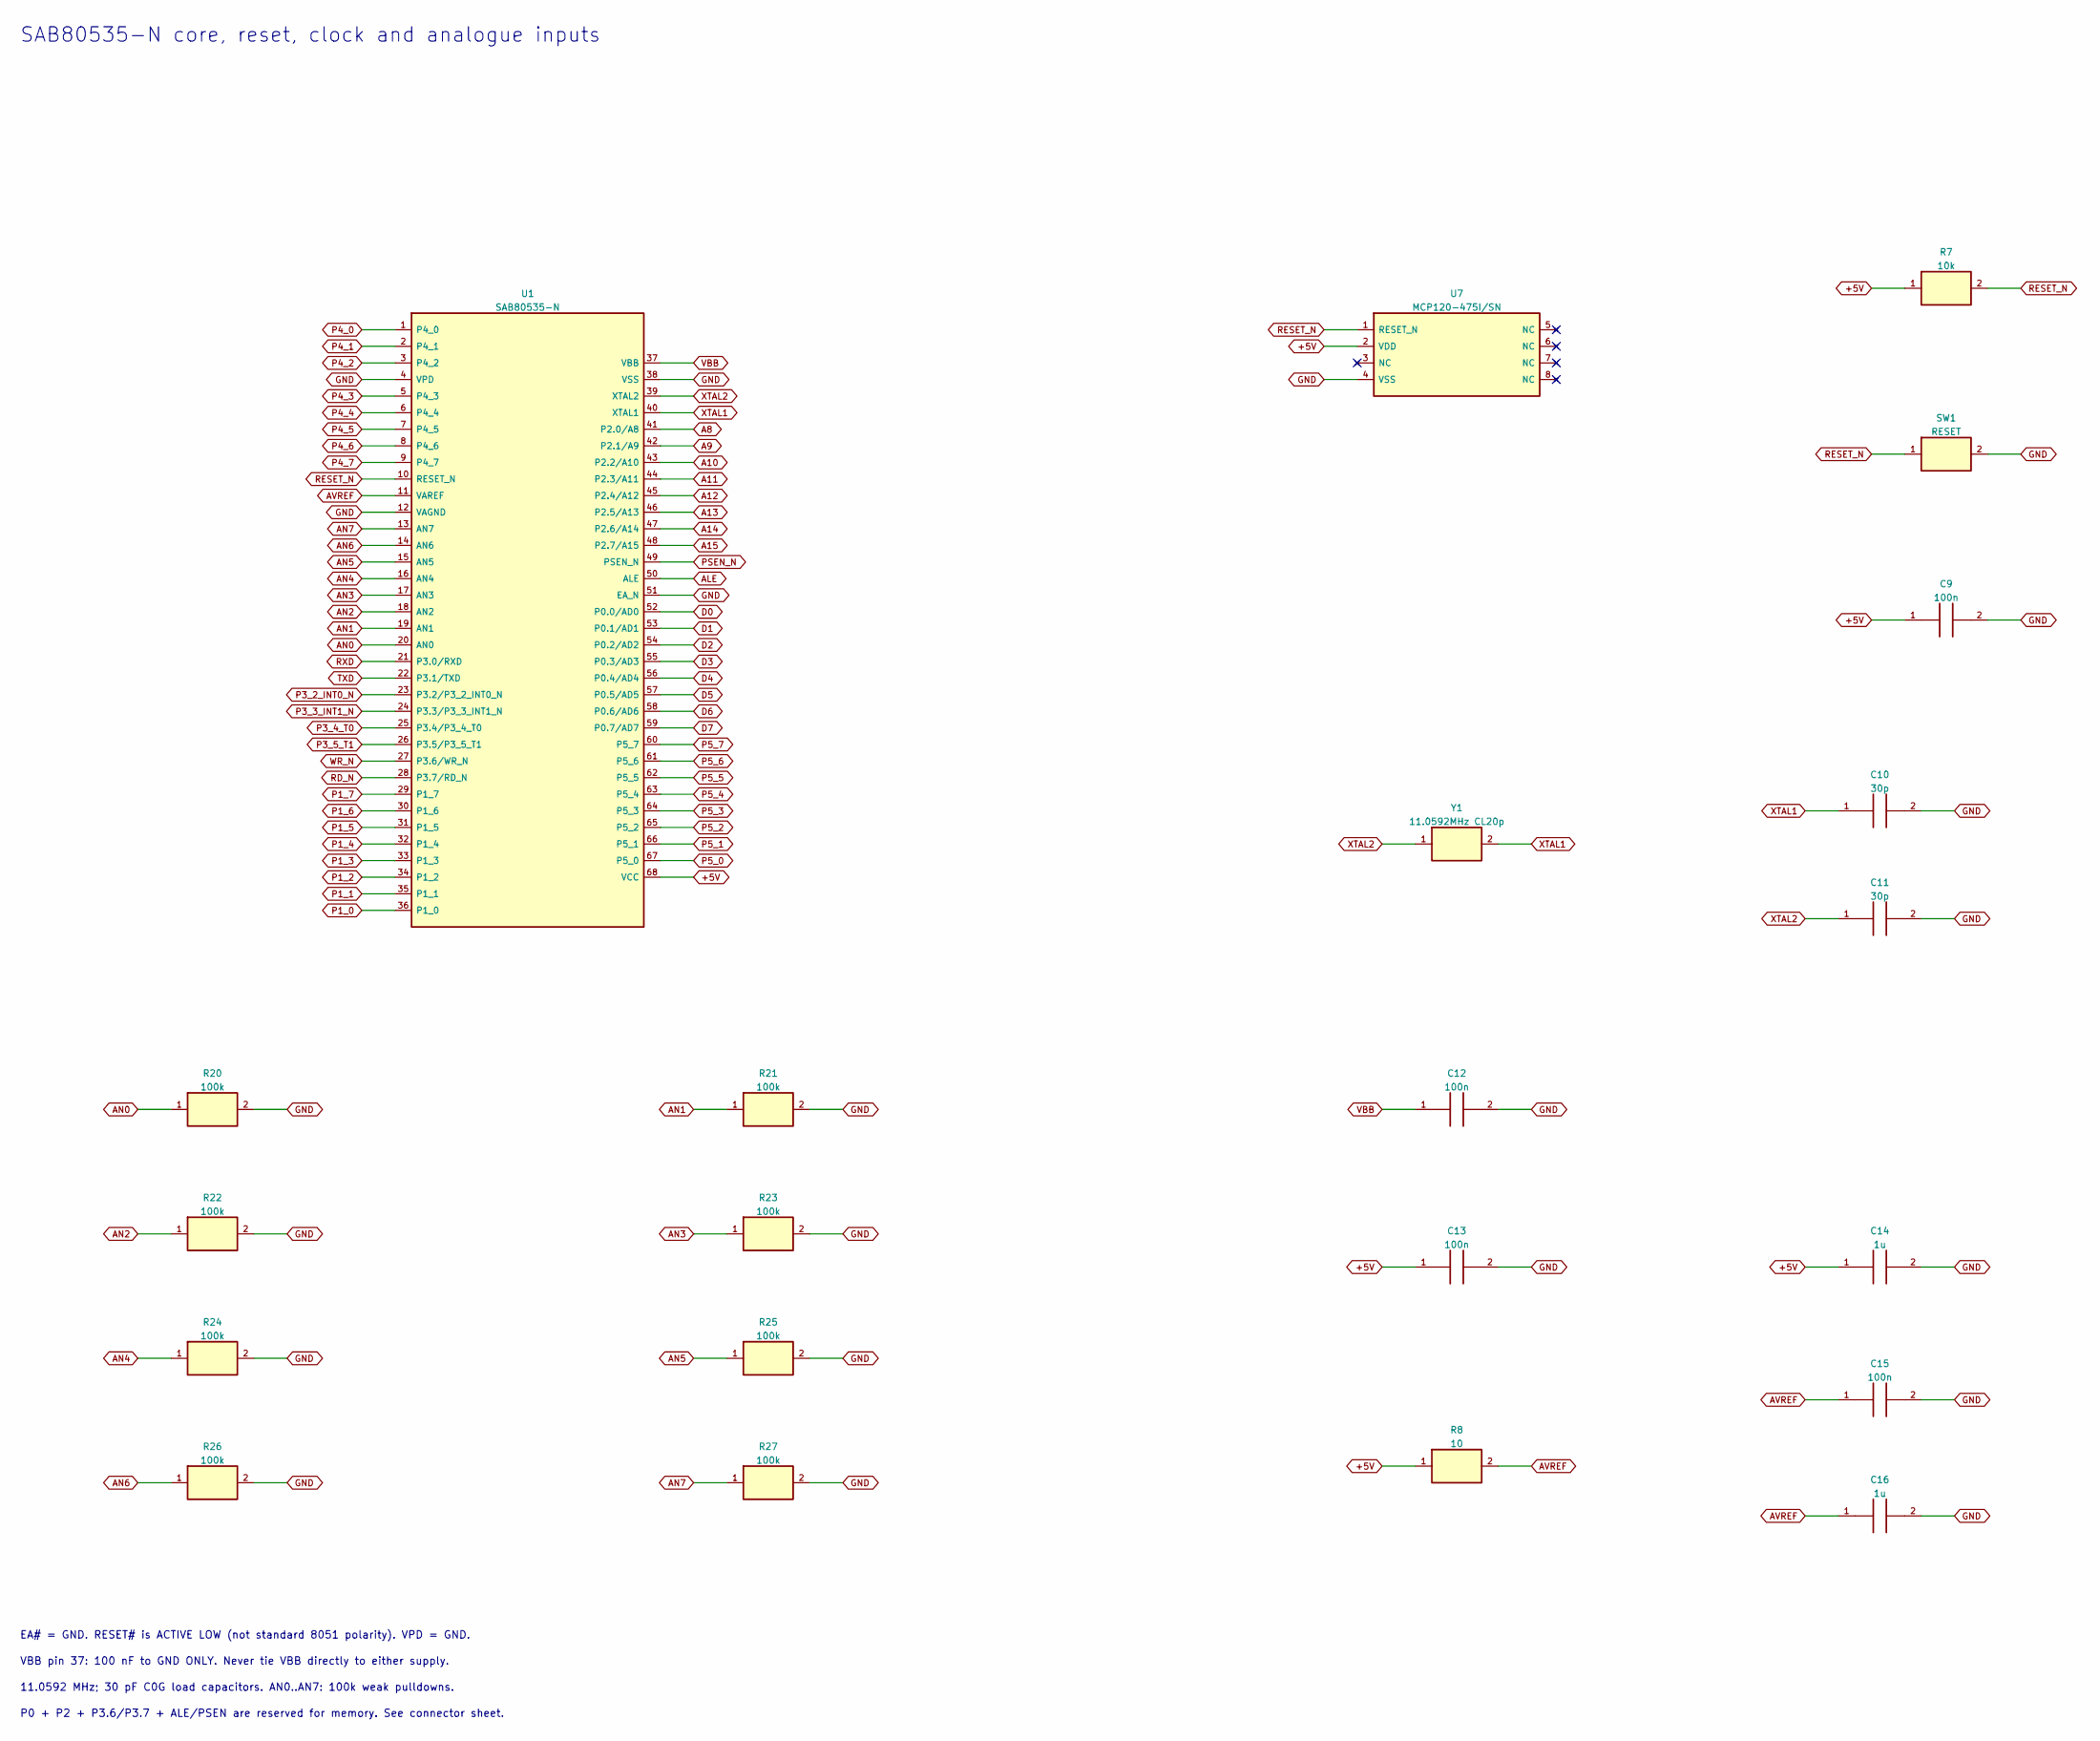
[picture p33: schematic sheet2.kicad_sch, Siemens SAB80535-N Retro Development Board]

Parts:
C9, C12, C13, C15: 100n; C_0805_2012Metric_Pad1.18x1.45mm_HandSolder; MPN GRM21BR71H104KA01L
C10, C11: 30p; C_0805_2012Metric_Pad1.18x1.45mm_HandSolder; MPN GRM2165C1H300JA01D
C14, C16: 1u; C_0805_2012Metric_Pad1.18x1.45mm_HandSolder; MPN GRM21BR71C105KA01L
R7: 10k; R_0805_2012Metric_Pad1.20x1.40mm_HandSolder; MPN RC0805FR-0710KL
R8: 10; R_0805_2012Metric_Pad1.20x1.40mm_HandSolder; MPN RC0805FR-0710RL
R20, R21, R22, R23, R24, R25, R26, R27: 100k; R_0805_2012Metric_Pad1.20x1.40mm_HandSolder; MPN RC0805FR-07100KL
SW1: RESET; SW_PUSH_6mm; MPN B3F-1000
U1: SAB80535-N; PLCC68_PreciDip_540-99-068-24-000-1; MPN SAB80535-N
U7: MCP120-475I/SN; SOIC-8_3.9x4.9mm_P1.27mm; MPN MCP120-475I/SN
Y1: 11.0592MHz CL20p; Crystal_HC49-U_Vertical; MPN ECS-110.5-20-4X

Connections:
+5V: C9.1, C13.1, C14.1, R7.1, R8.1, U1.68 (VCC), U7.2 (VDD); also elsewhere on the board
A8: U1.41 (P2.0/A8); also elsewhere on the board
A9: U1.42 (P2.1/A9); also elsewhere on the board
A10: U1.43 (P2.2/A10); also elsewhere on the board
A11: U1.44 (P2.3/A11); also elsewhere on the board
A12: U1.45 (P2.4/A12); also elsewhere on the board
A13: U1.46 (P2.5/A13); also elsewhere on the board
A14: U1.47 (P2.6/A14); also elsewhere on the board
A15: U1.48 (P2.7/A15); also elsewhere on the board
ALE: U1.50 (ALE); also elsewhere on the board
AN0: R20.1, U1.20 (AN0); also elsewhere on the board
AN1: R21.1, U1.19 (AN1); also elsewhere on the board
AN2: R22.1, U1.18 (AN2); also elsewhere on the board
AN3: R23.1, U1.17 (AN3); also elsewhere on the board
AN4: R24.1, U1.16 (AN4); also elsewhere on the board
AN5: R25.1, U1.15 (AN5); also elsewhere on the board
AN6: R26.1, U1.14 (AN6); also elsewhere on the board
AN7: R27.1, U1.13 (AN7); also elsewhere on the board
AVREF: C15.1, C16.1, R8.2, U1.11 (VAREF); also elsewhere on the board
D0: U1.52 (P0.0/AD0); also elsewhere on the board
D1: U1.53 (P0.1/AD1); also elsewhere on the board
D2: U1.54 (P0.2/AD2); also elsewhere on the board
D3: U1.55 (P0.3/AD3); also elsewhere on the board
D4: U1.56 (P0.4/AD4); also elsewhere on the board
D5: U1.57 (P0.5/AD5); also elsewhere on the board
D6: U1.58 (P0.6/AD6); also elsewhere on the board
D7: U1.59 (P0.7/AD7); also elsewhere on the board
GND: C9.2, C10.2, C11.2, C12.2, C13.2, C14.2, C15.2, C16.2, R20.2, R21.2, R22.2, R23.2, R24.2, R25.2, R26.2, R27.2, SW1.2, U1.4 (VPD), U1.12 (VAGND), U1.38 (VSS), U1.51 (EA_N), U7.4 (VSS); also elsewhere on the board
P1_0: U1.36 (P1_0); also elsewhere on the board
P1_1: U1.35 (P1_1); also elsewhere on the board
P1_2: U1.34 (P1_2); also elsewhere on the board
P1_3: U1.33 (P1_3); also elsewhere on the board
P1_4: U1.32 (P1_4); also elsewhere on the board
P1_5: U1.31 (P1_5); also elsewhere on the board
P1_6: U1.30 (P1_6); also elsewhere on the board
P1_7: U1.29 (P1_7); also elsewhere on the board
P3_2_INT0_N: U1.23 (P3.2/P3_2_INT0_N); also elsewhere on the board
P3_3_INT1_N: U1.24 (P3.3/P3_3_INT1_N); also elsewhere on the board
P3_4_T0: U1.25 (P3.4/P3_4_T0); also elsewhere on the board
P3_5_T1: U1.26 (P3.5/P3_5_T1); also elsewhere on the board
P4_0: U1.1 (P4_0); also elsewhere on the board
P4_1: U1.2 (P4_1); also elsewhere on the board
P4_2: U1.3 (P4_2); also elsewhere on the board
P4_3: U1.5 (P4_3); also elsewhere on the board
P4_4: U1.6 (P4_4); also elsewhere on the board
P4_5: U1.7 (P4_5); also elsewhere on the board
P4_6: U1.8 (P4_6); also elsewhere on the board
P4_7: U1.9 (P4_7); also elsewhere on the board
P5_0: U1.67 (P5_0); also elsewhere on the board
P5_1: U1.66 (P5_1); also elsewhere on the board
P5_2: U1.65 (P5_2); also elsewhere on the board
P5_3: U1.64 (P5_3); also elsewhere on the board
P5_4: U1.63 (P5_4); also elsewhere on the board
P5_5: U1.62 (P5_5); also elsewhere on the board
P5_6: U1.61 (P5_6); also elsewhere on the board
P5_7: U1.60 (P5_7); also elsewhere on the board
PSEN_N: U1.49 (PSEN_N); also elsewhere on the board
RD_N: U1.28 (P3.7/RD_N); also elsewhere on the board
RESET_N: R7.2, SW1.1, U1.10 (RESET_N), U7.1 (RESET_N); also elsewhere on the board
RXD: U1.21 (P3.0/RXD); also elsewhere on the board
TXD: U1.22 (P3.1/TXD); also elsewhere on the board
VBB: C12.1, U1.37 (VBB)
WR_N: U1.27 (P3.6/WR_N); also elsewhere on the board
XTAL1: C10.1, U1.40 (XTAL1), Y1.2
XTAL2: C11.1, U1.39 (XTAL2), Y1.1

Notes on the sheet:
SAB80535-N core, reset, clock and analogue inputs
EA# = GND. RESET# is ACTIVE LOW (not standard 8051 polarity). VPD = GND.
VBB pin 37: 100 nF to GND ONLY. Never tie VBB directly to either supply.
11.0592 MHz; 30 pF C0G load capacitors. AN0..AN7: 100k weak pulldowns.
P0 + P2 + P3.6/P3.7 + ALE/PSEN are reserved for memory. See connector sheet.

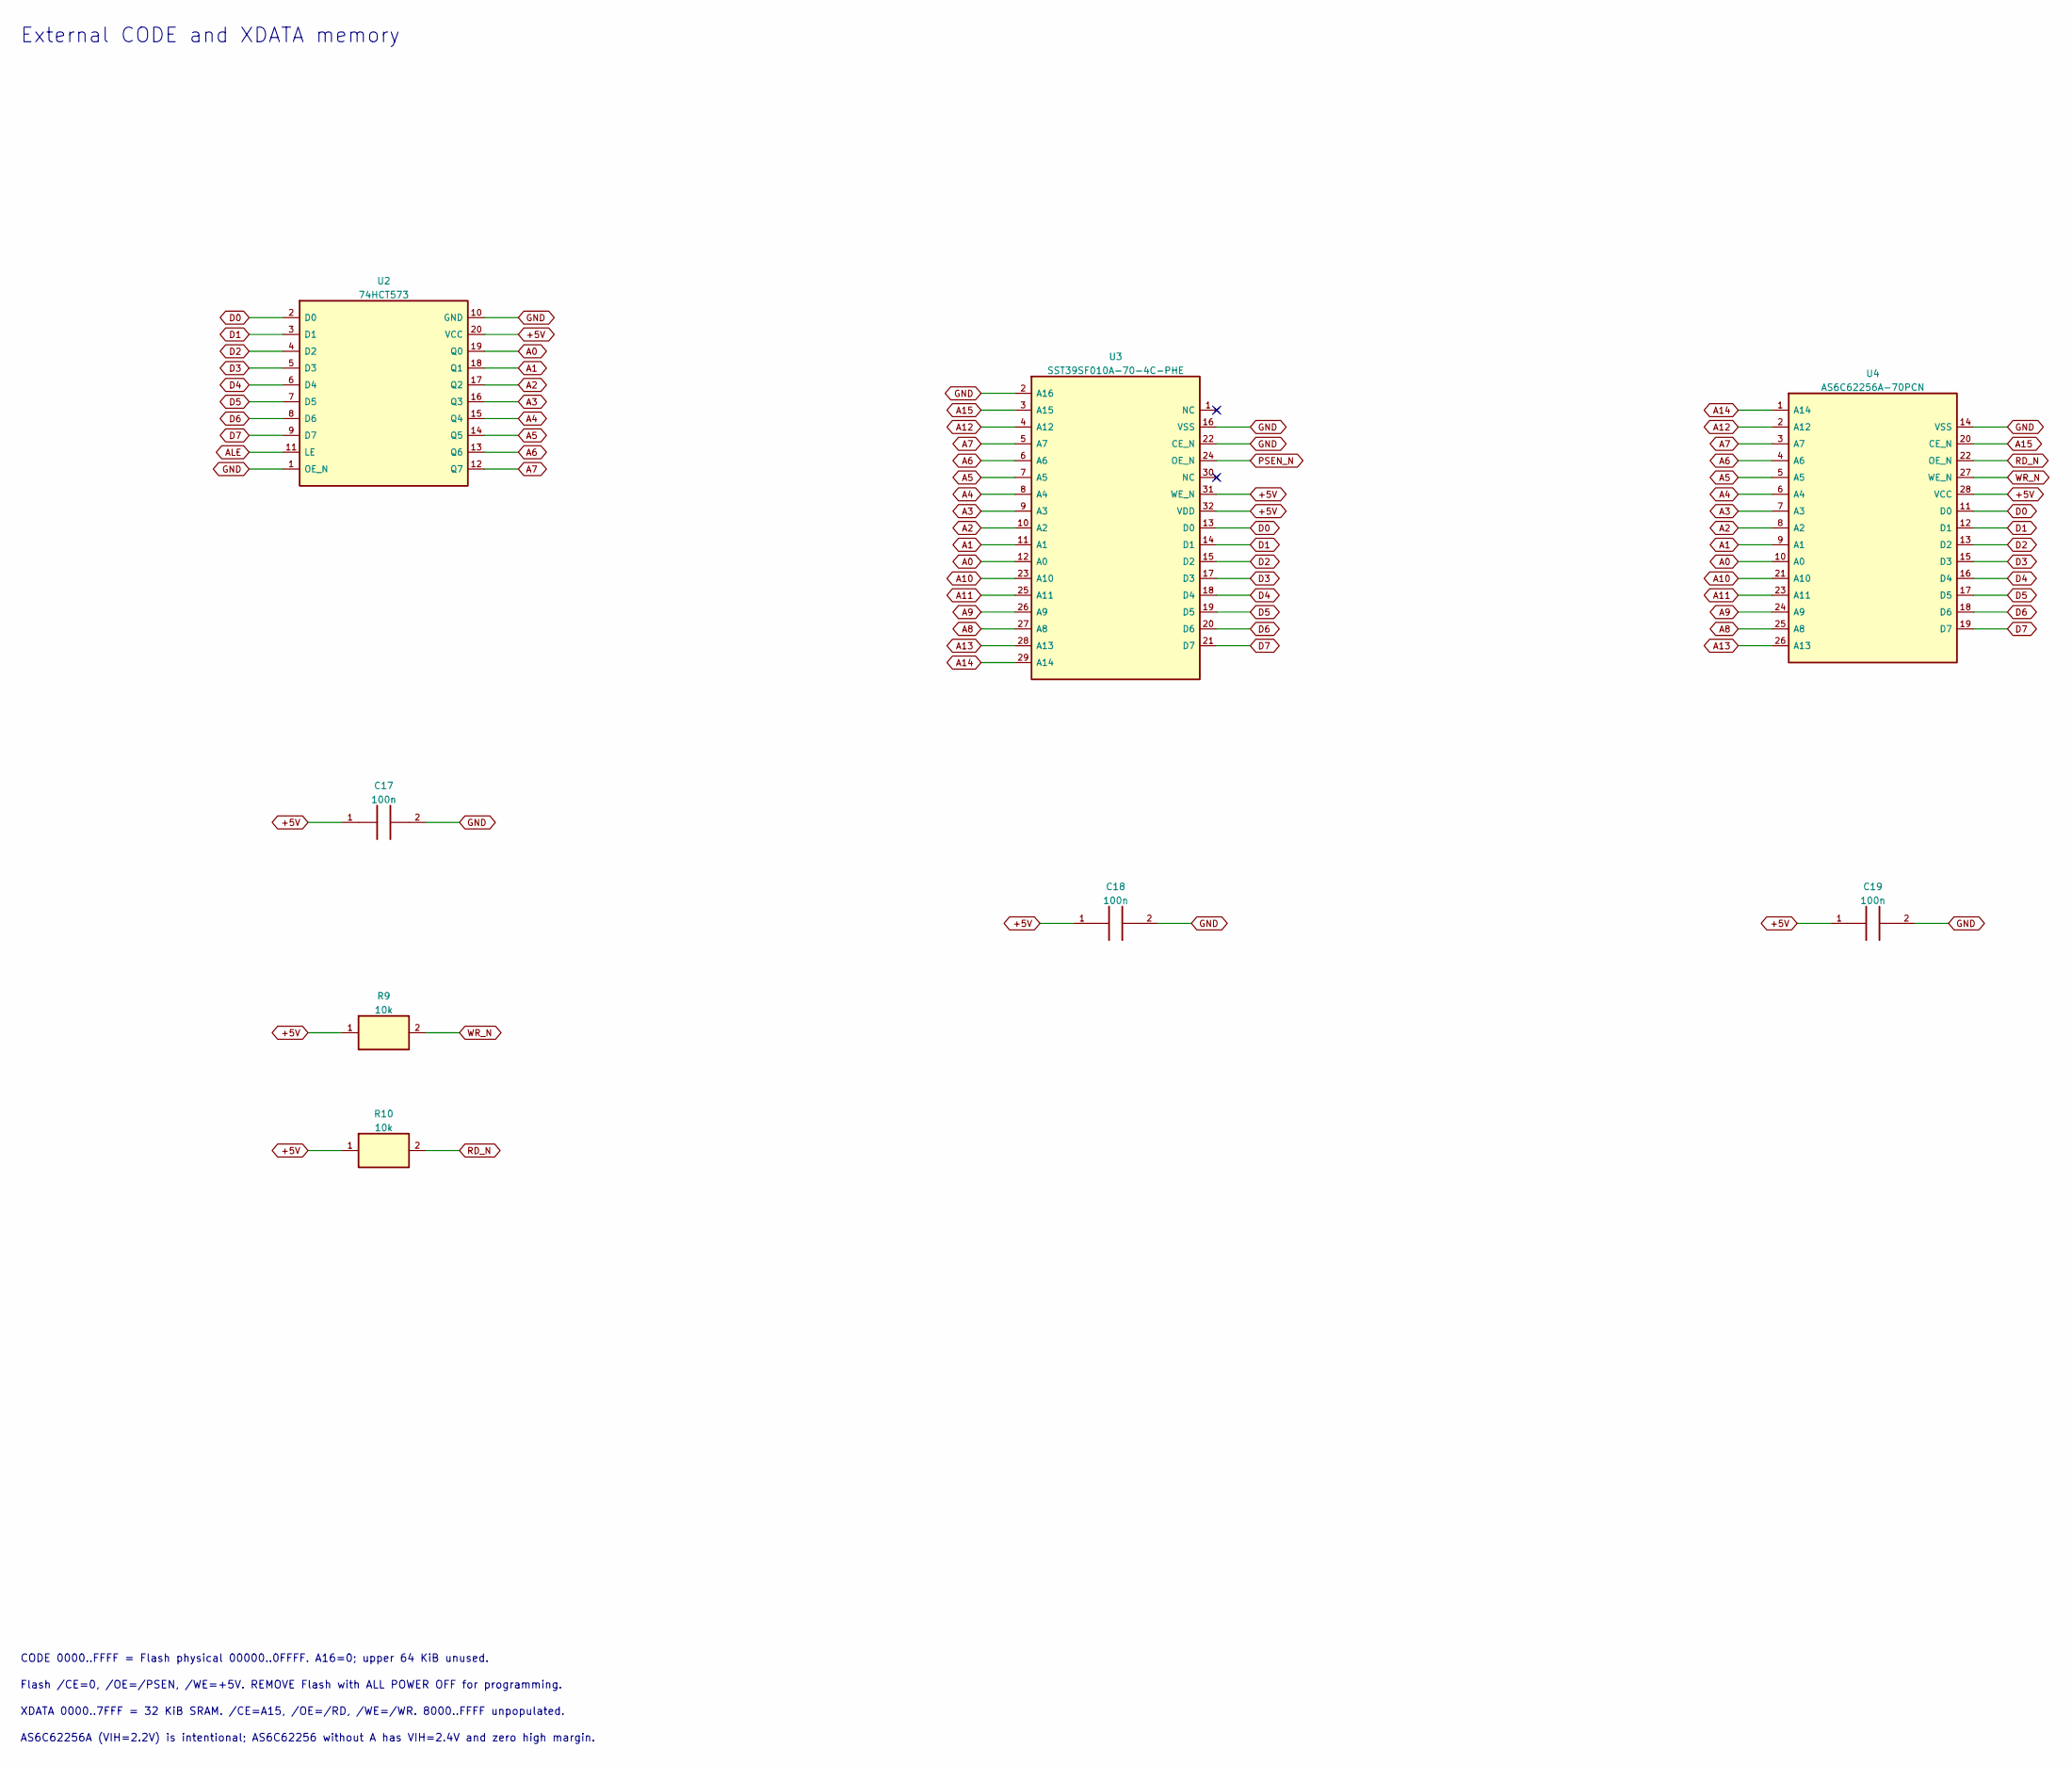
[picture p34: schematic sheet3.kicad_sch, Siemens SAB80535-N Retro Development Board]

Parts:
C17, C18, C19: 100n; C_0805_2012Metric_Pad1.18x1.45mm_HandSolder; MPN GRM21BR71H104KA01L
R9, R10: 10k; R_0805_2012Metric_Pad1.20x1.40mm_HandSolder; MPN RC0805FR-0710KL
U2: 74HCT573; SOIC-20W_7.5x12.8mm_P1.27mm; MPN SN74HCT573DWR
U3: SST39SF010A-70-4C-PHE; DIP-32_W15.24mm_Socket_LongPads; MPN SST39SF010A-70-4C-PHE
U4: AS6C62256A-70PCN; DIP-28_W15.24mm_Socket_LongPads; MPN AS6C62256A-70PCN

Connections:
+5V: C17.1, C18.1, C19.1, R9.1, R10.1, U2.20 (VCC), U3.31 (WE_N), U3.32 (VDD), U4.28 (VCC); also elsewhere on the board
A0: U2.19 (Q0), U3.12 (A0), U4.10 (A0); also elsewhere on the board
A1: U2.18 (Q1), U3.11 (A1), U4.9 (A1); also elsewhere on the board
A2: U2.17 (Q2), U3.10 (A2), U4.8 (A2); also elsewhere on the board
A3: U2.16 (Q3), U3.9 (A3), U4.7 (A3); also elsewhere on the board
A4: U2.15 (Q4), U3.8 (A4), U4.6 (A4); also elsewhere on the board
A5: U2.14 (Q5), U3.7 (A5), U4.5 (A5); also elsewhere on the board
A6: U2.13 (Q6), U3.6 (A6), U4.4 (A6); also elsewhere on the board
A7: U2.12 (Q7), U3.5 (A7), U4.3 (A7); also elsewhere on the board
A8: U3.27 (A8), U4.25 (A8); also elsewhere on the board
A9: U3.26 (A9), U4.24 (A9); also elsewhere on the board
A10: U3.23 (A10), U4.21 (A10); also elsewhere on the board
A11: U3.25 (A11), U4.23 (A11); also elsewhere on the board
A12: U3.4 (A12), U4.2 (A12); also elsewhere on the board
A13: U3.28 (A13), U4.26 (A13); also elsewhere on the board
A14: U3.29 (A14), U4.1 (A14); also elsewhere on the board
A15: U3.3 (A15), U4.20 (CE_N); also elsewhere on the board
ALE: U2.11 (LE); also elsewhere on the board
D0: U2.2 (D0), U3.13 (D0), U4.11 (D0); also elsewhere on the board
D1: U2.3 (D1), U3.14 (D1), U4.12 (D1); also elsewhere on the board
D2: U2.4 (D2), U3.15 (D2), U4.13 (D2); also elsewhere on the board
D3: U2.5 (D3), U3.17 (D3), U4.15 (D3); also elsewhere on the board
D4: U2.6 (D4), U3.18 (D4), U4.16 (D4); also elsewhere on the board
D5: U2.7 (D5), U3.19 (D5), U4.17 (D5); also elsewhere on the board
D6: U2.8 (D6), U3.20 (D6), U4.18 (D6); also elsewhere on the board
D7: U2.9 (D7), U3.21 (D7), U4.19 (D7); also elsewhere on the board
GND: C17.2, C18.2, C19.2, U2.1 (OE_N), U2.10 (GND), U3.2 (A16), U3.16 (VSS), U3.22 (CE_N), U4.14 (VSS); also elsewhere on the board
PSEN_N: U3.24 (OE_N); also elsewhere on the board
RD_N: R10.2, U4.22 (OE_N); also elsewhere on the board
WR_N: R9.2, U4.27 (WE_N); also elsewhere on the board

Notes on the sheet:
External CODE and XDATA memory
CODE 0000..FFFF = Flash physical 00000..0FFFF. A16=0; upper 64 KiB unused.
Flash /CE=0, /OE=/PSEN, /WE=+5V. REMOVE Flash with ALL POWER OFF for programming.
XDATA 0000..7FFF = 32 KiB SRAM. /CE=A15, /OE=/RD, /WE=/WR. 8000..FFFF unpopulated.
AS6C62256A (VIH=2.2V) is intentional; AS6C62256 without A has VIH=2.4V and zero high margin.
