adsdevdoo/retro535/hardware/retro535.kicad_pcb

## KiCad design hardware/retro535.kicad_pcb (continued)

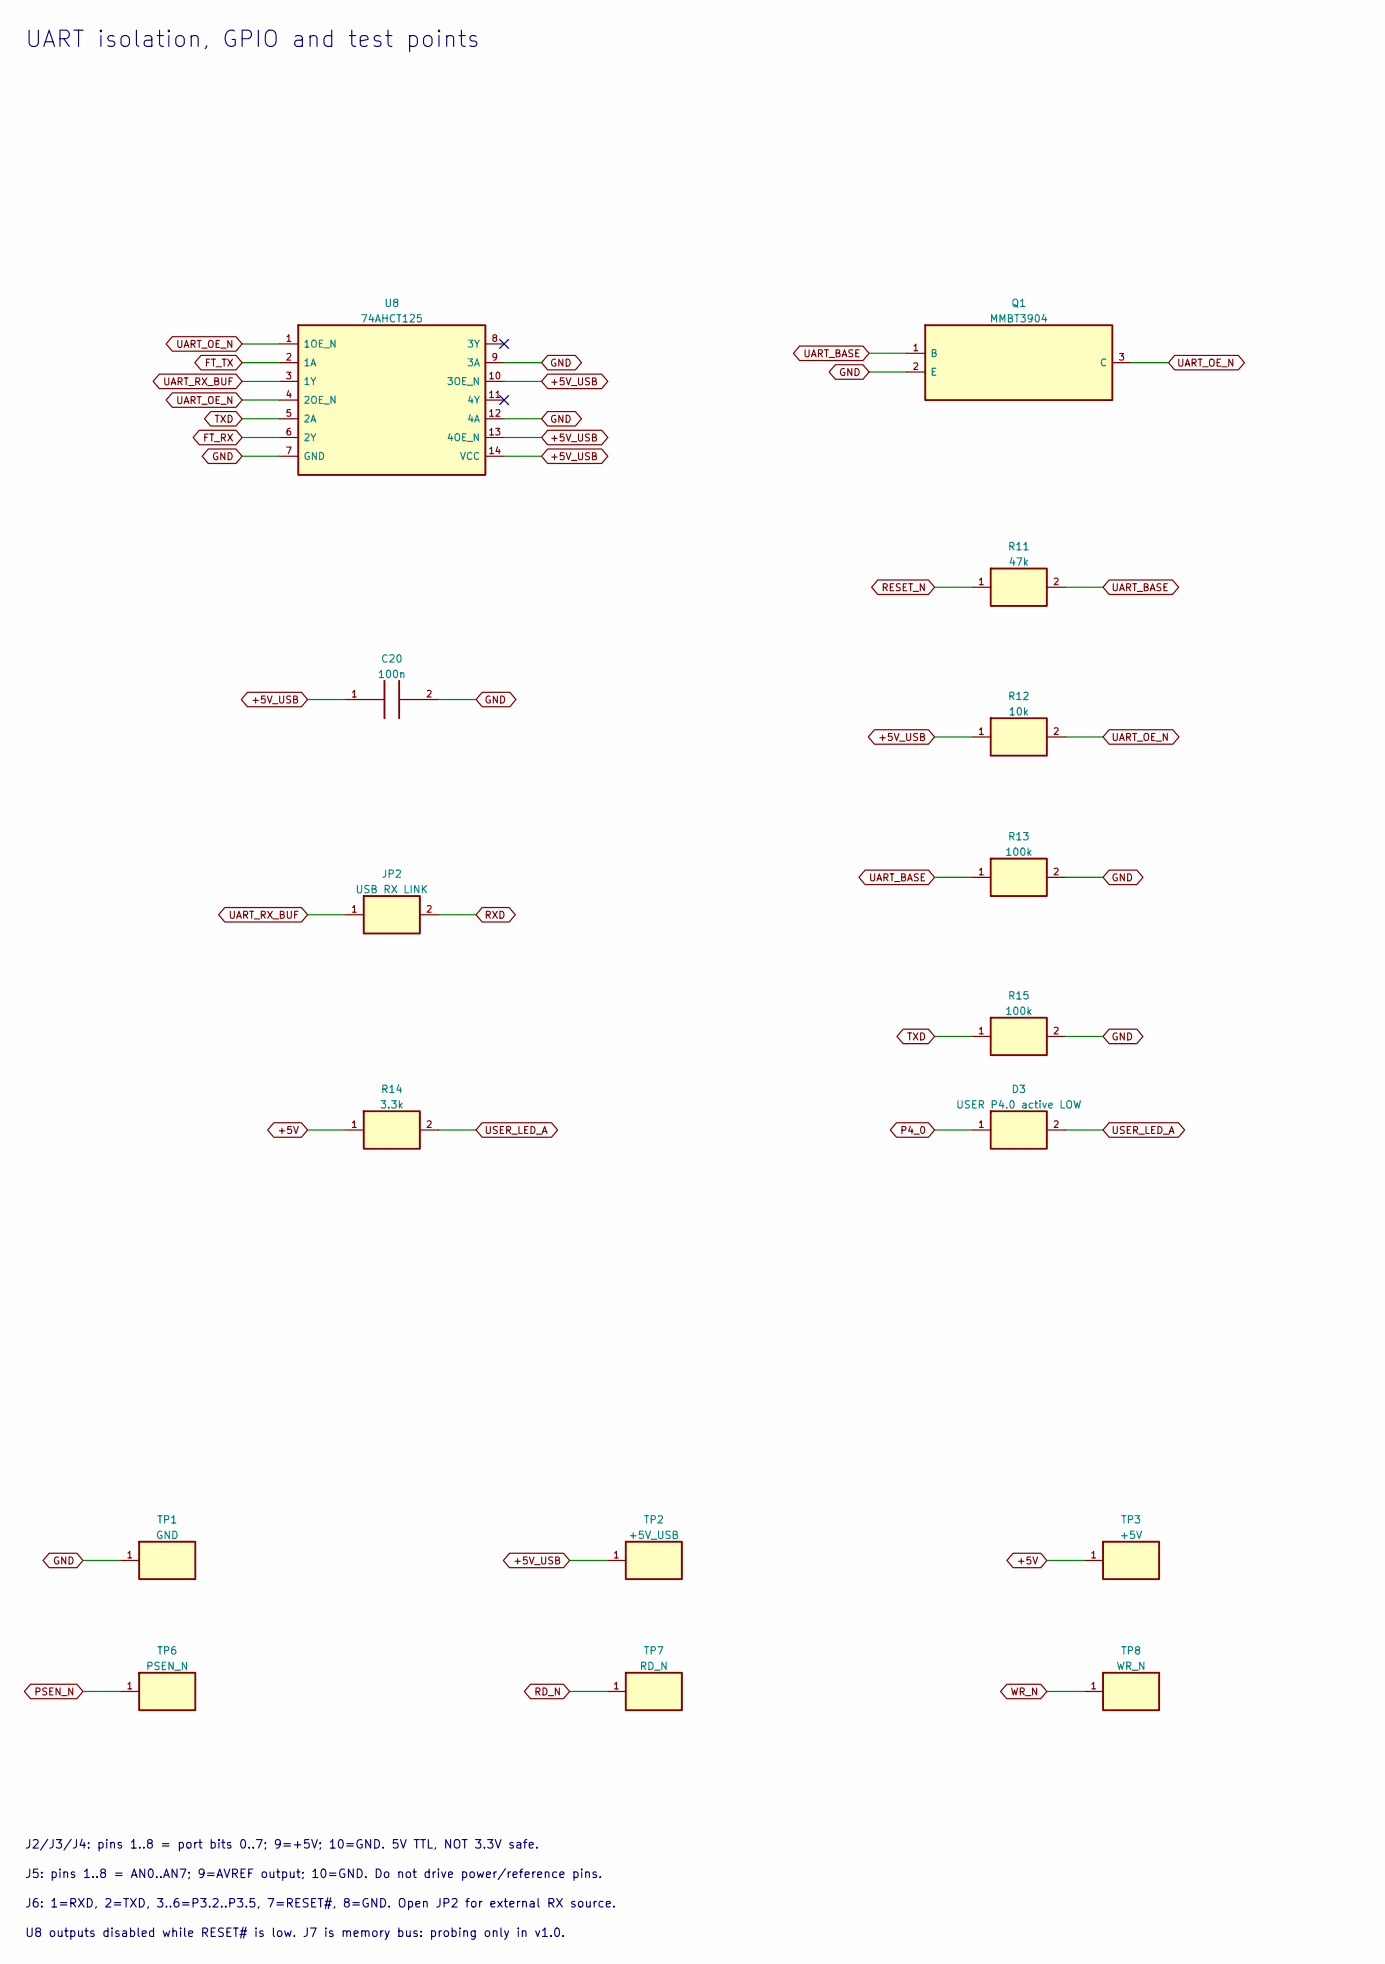
[picture p35: schematic sheet4.kicad_sch, Siemens SAB80535-N Retro Development Board, part in row 1, column 1]

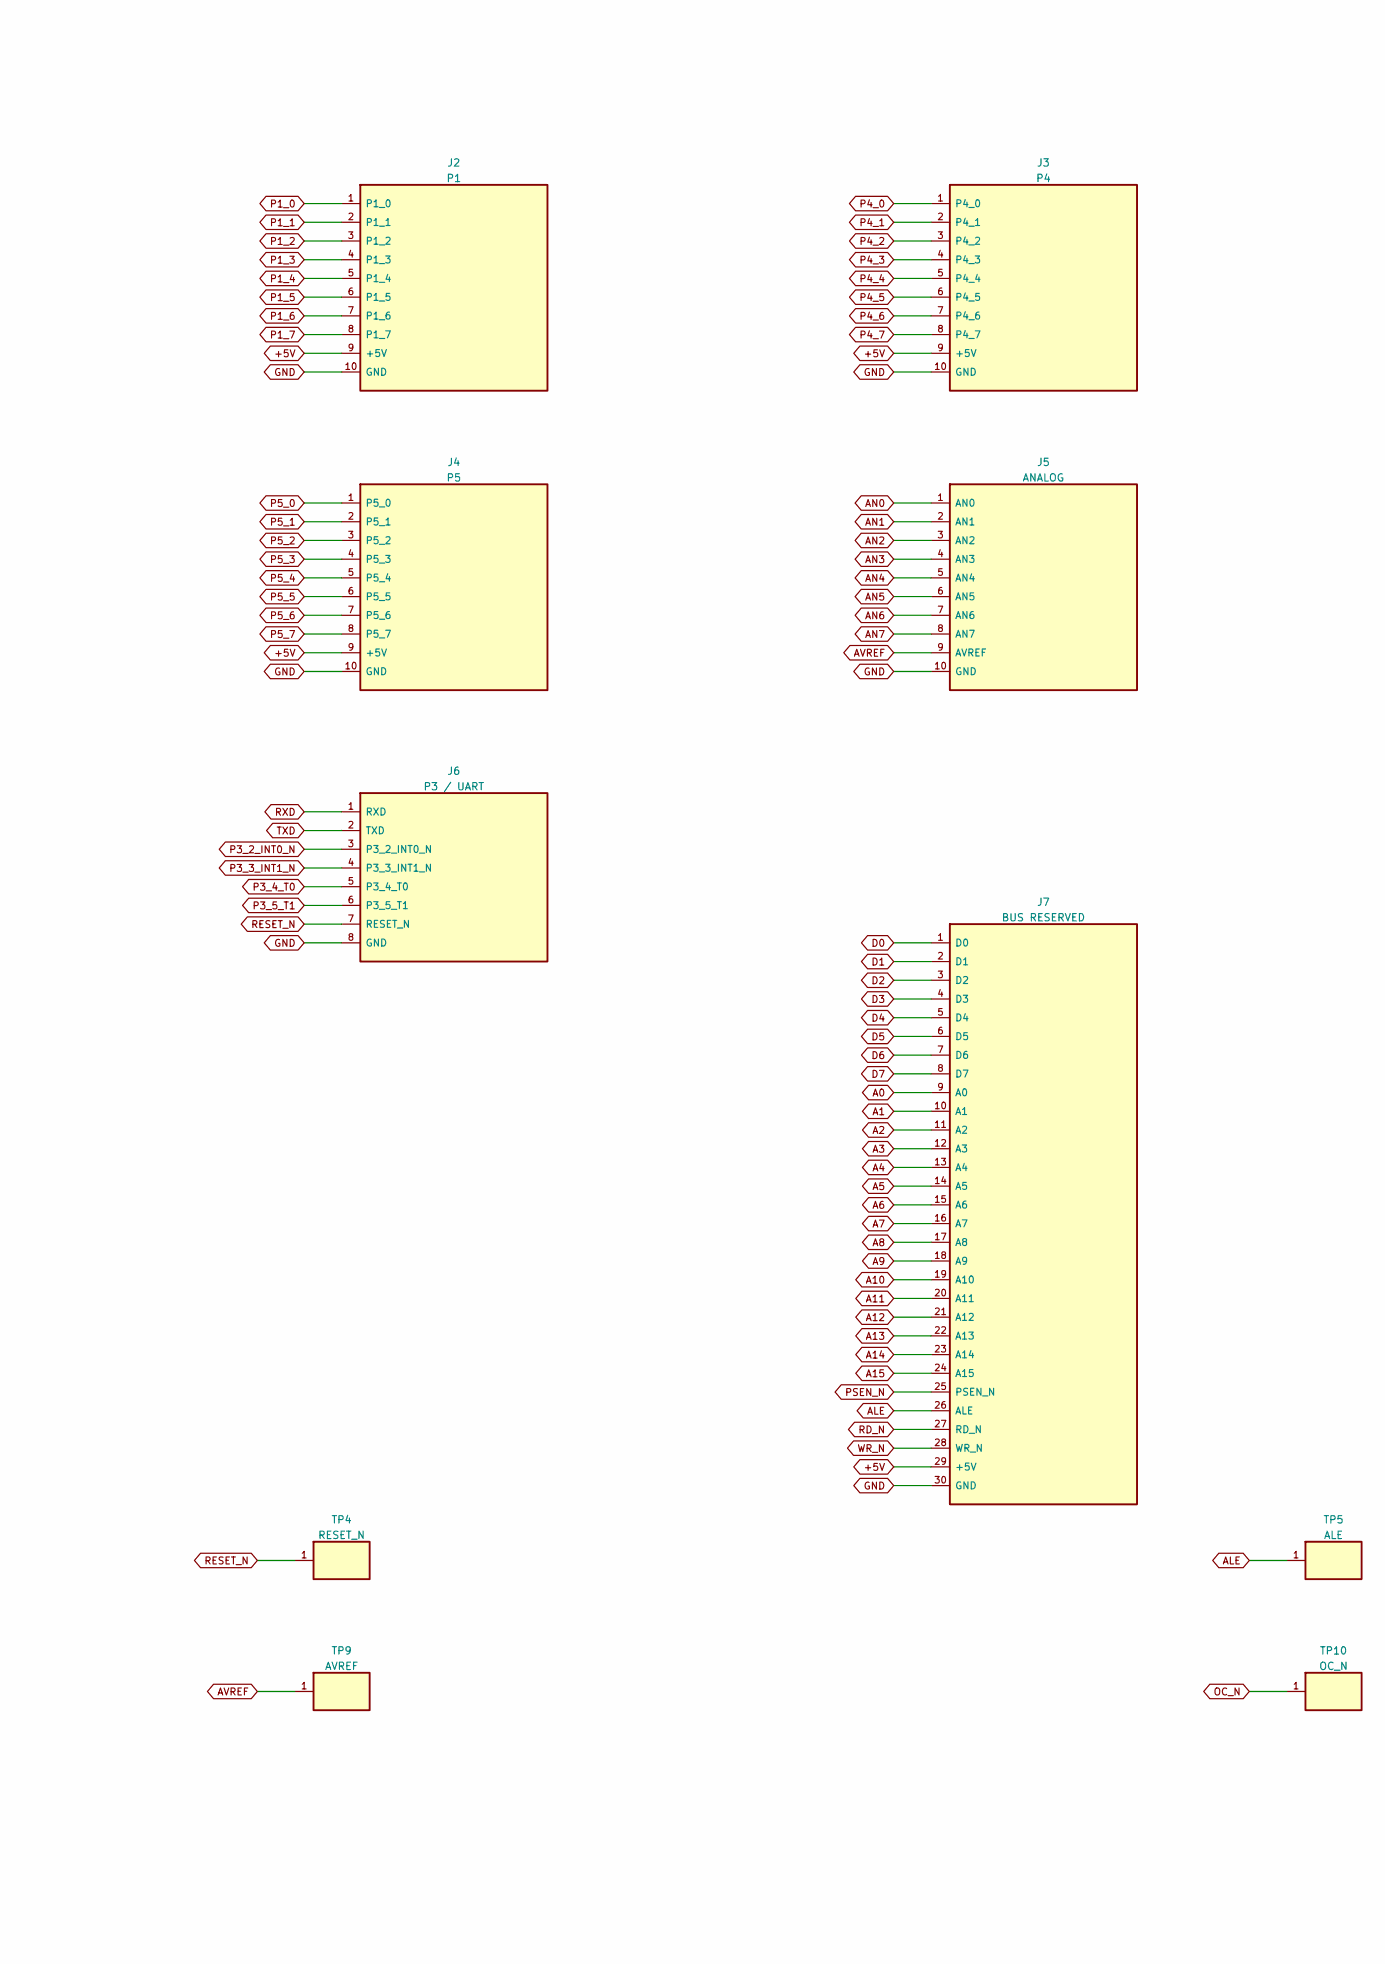
[picture p36: schematic sheet4.kicad_sch, Siemens SAB80535-N Retro Development Board, part in row 1, column 2]

Parts:
C20: 100n; C_0805_2012Metric_Pad1.18x1.45mm_HandSolder; MPN GRM21BR71H104KA01L
D3: USER P4.0 active LOW; LED_0805_2012Metric_Pad1.15x1.40mm_HandSolder; MPN LTST-C170KRKT
J2: P1; PinHeader_2x05_P2.54mm_Vertical; MPN M20-9980546
J3: P4; PinHeader_2x05_P2.54mm_Vertical; MPN M20-9980546
J4: P5; PinHeader_2x05_P2.54mm_Vertical; MPN M20-9980546
J5: ANALOG; PinHeader_2x05_P2.54mm_Vertical; MPN M20-9980546
J6: P3 / UART; PinHeader_2x04_P2.54mm_Vertical; MPN M20-9980446
J7: BUS RESERVED; PinHeader_2x15_P2.54mm_Vertical; MPN M20-9981546
JP2: USB RX LINK; PinHeader_1x02_P2.54mm_Vertical; MPN M20-9990245
Q1: MMBT3904; SOT-23; MPN MMBT3904
R11: 47k; R_0805_2012Metric_Pad1.20x1.40mm_HandSolder; MPN RC0805FR-0747KL
R12: 10k; R_0805_2012Metric_Pad1.20x1.40mm_HandSolder; MPN RC0805FR-0710KL
R13, R15: 100k; R_0805_2012Metric_Pad1.20x1.40mm_HandSolder; MPN RC0805FR-07100KL
R14: 3.3k; R_0805_2012Metric_Pad1.20x1.40mm_HandSolder; MPN RC0805FR-073K3L
TP1: GND; TestPoint_Pad_D2.0mm; MPN PCB test pad
TP2: +5V_USB; TestPoint_Pad_D2.0mm; MPN PCB test pad
TP3: +5V; TestPoint_Pad_D2.0mm; MPN PCB test pad
TP4: RESET_N; TestPoint_Pad_D2.0mm; MPN PCB test pad
TP5: ALE; TestPoint_Pad_D2.0mm; MPN PCB test pad
TP6: PSEN_N; TestPoint_Pad_D2.0mm; MPN PCB test pad
TP7: RD_N; TestPoint_Pad_D2.0mm; MPN PCB test pad
TP8: WR_N; TestPoint_Pad_D2.0mm; MPN PCB test pad
TP9: AVREF; TestPoint_Pad_D2.0mm; MPN PCB test pad
TP10: OC_N; TestPoint_Pad_D2.0mm; MPN PCB test pad
U8: 74AHCT125; SOIC-14_3.9x8.7mm_P1.27mm; MPN SN74AHCT125DR

Connections:
+5V: J2.9 (+5V), J3.9 (+5V), J4.9 (+5V), J7.29 (+5V), R14.1, TP3.1; also elsewhere on the board
+5V_USB: C20.1, R12.1, TP2.1, U8.10 (3OE_N), U8.13 (4OE_N), U8.14 (VCC); also elsewhere on the board
A0: J7.9 (A0); also elsewhere on the board
A1: J7.10 (A1); also elsewhere on the board
A2: J7.11 (A2); also elsewhere on the board
A3: J7.12 (A3); also elsewhere on the board
A4: J7.13 (A4); also elsewhere on the board
A5: J7.14 (A5); also elsewhere on the board
A6: J7.15 (A6); also elsewhere on the board
A7: J7.16 (A7); also elsewhere on the board
A8: J7.17 (A8); also elsewhere on the board
A9: J7.18 (A9); also elsewhere on the board
A10: J7.19 (A10); also elsewhere on the board
A11: J7.20 (A11); also elsewhere on the board
A12: J7.21 (A12); also elsewhere on the board
A13: J7.22 (A13); also elsewhere on the board
A14: J7.23 (A14); also elsewhere on the board
A15: J7.24 (A15); also elsewhere on the board
ALE: J7.26 (ALE), TP5.1; also elsewhere on the board
AN0: J5.1 (AN0); also elsewhere on the board
AN1: J5.2 (AN1); also elsewhere on the board
AN2: J5.3 (AN2); also elsewhere on the board
AN3: J5.4 (AN3); also elsewhere on the board
AN4: J5.5 (AN4); also elsewhere on the board
AN5: J5.6 (AN5); also elsewhere on the board
AN6: J5.7 (AN6); also elsewhere on the board
AN7: J5.8 (AN7); also elsewhere on the board
AVREF: J5.9 (AVREF), TP9.1; also elsewhere on the board
D0: J7.1 (D0); also elsewhere on the board
D1: J7.2 (D1); also elsewhere on the board
D2: J7.3 (D2); also elsewhere on the board
D3: J7.4 (D3); also elsewhere on the board
D4: J7.5 (D4); also elsewhere on the board
D5: J7.6 (D5); also elsewhere on the board
D6: J7.7 (D6); also elsewhere on the board
D7: J7.8 (D7); also elsewhere on the board
FT_RX: U8.6 (2Y); also elsewhere on the board
FT_TX: U8.2 (1A); also elsewhere on the board
GND: C20.2, J2.10 (GND), J3.10 (GND), J4.10 (GND), J5.10 (GND), J6.8 (GND), J7.30 (GND), Q1.2 (E), R13.2, R15.2, TP1.1, U8.7 (GND), U8.9 (3A), U8.12 (4A); also elsewhere on the board
OC_N: TP10.1; also elsewhere on the board
P1_0: J2.1 (P1_0); also elsewhere on the board
P1_1: J2.2 (P1_1); also elsewhere on the board
P1_2: J2.3 (P1_2); also elsewhere on the board
P1_3: J2.4 (P1_3); also elsewhere on the board
P1_4: J2.5 (P1_4); also elsewhere on the board
P1_5: J2.6 (P1_5); also elsewhere on the board
P1_6: J2.7 (P1_6); also elsewhere on the board
P1_7: J2.8 (P1_7); also elsewhere on the board
P3_2_INT0_N: J6.3 (P3_2_INT0_N); also elsewhere on the board
P3_3_INT1_N: J6.4 (P3_3_INT1_N); also elsewhere on the board
P3_4_T0: J6.5 (P3_4_T0); also elsewhere on the board
P3_5_T1: J6.6 (P3_5_T1); also elsewhere on the board
P4_0: D3.1, J3.1 (P4_0); also elsewhere on the board
P4_1: J3.2 (P4_1); also elsewhere on the board
P4_2: J3.3 (P4_2); also elsewhere on the board
P4_3: J3.4 (P4_3); also elsewhere on the board
P4_4: J3.5 (P4_4); also elsewhere on the board
P4_5: J3.6 (P4_5); also elsewhere on the board
P4_6: J3.7 (P4_6); also elsewhere on the board
P4_7: J3.8 (P4_7); also elsewhere on the board
P5_0: J4.1 (P5_0); also elsewhere on the board
P5_1: J4.2 (P5_1); also elsewhere on the board
P5_2: J4.3 (P5_2); also elsewhere on the board
P5_3: J4.4 (P5_3); also elsewhere on the board
P5_4: J4.5 (P5_4); also elsewhere on the board
P5_5: J4.6 (P5_5); also elsewhere on the board
P5_6: J4.7 (P5_6); also elsewhere on the board
P5_7: J4.8 (P5_7); also elsewhere on the board
PSEN_N: J7.25 (PSEN_N), TP6.1; also elsewhere on the board
RD_N: J7.27 (RD_N), TP7.1; also elsewhere on the board
RESET_N: J6.7 (RESET_N), R11.1, TP4.1; also elsewhere on the board
RXD: J6.1 (RXD), JP2.2; also elsewhere on the board
TXD: J6.2 (TXD), R15.1, U8.5 (2A); also elsewhere on the board
UART_BASE: Q1.1 (B), R11.2, R13.1
UART_OE_N: Q1.3 (C), R12.2, U8.1 (1OE_N), U8.4 (2OE_N)
UART_RX_BUF: JP2.1, U8.3 (1Y)
USER_LED_A: D3.2, R14.2
WR_N: J7.28 (WR_N), TP8.1; also elsewhere on the board

Notes on the sheet:
UART isolation, GPIO and test points
J2/J3/J4: pins 1..8 = port bits 0..7; 9=+5V; 10=GND. 5V TTL, NOT 3.3V safe.
J5: pins 1..8 = AN0..AN7; 9=AVREF output; 10=GND. Do not drive power/reference pins.
J6: 1=RXD, 2=TXD, 3..6=P3.2..P3.5, 7=RESET#, 8=GND. Open JP2 for external RX source.
U8 outputs disabled while RESET# is low. J7 is memory bus: probing only in v1.0.

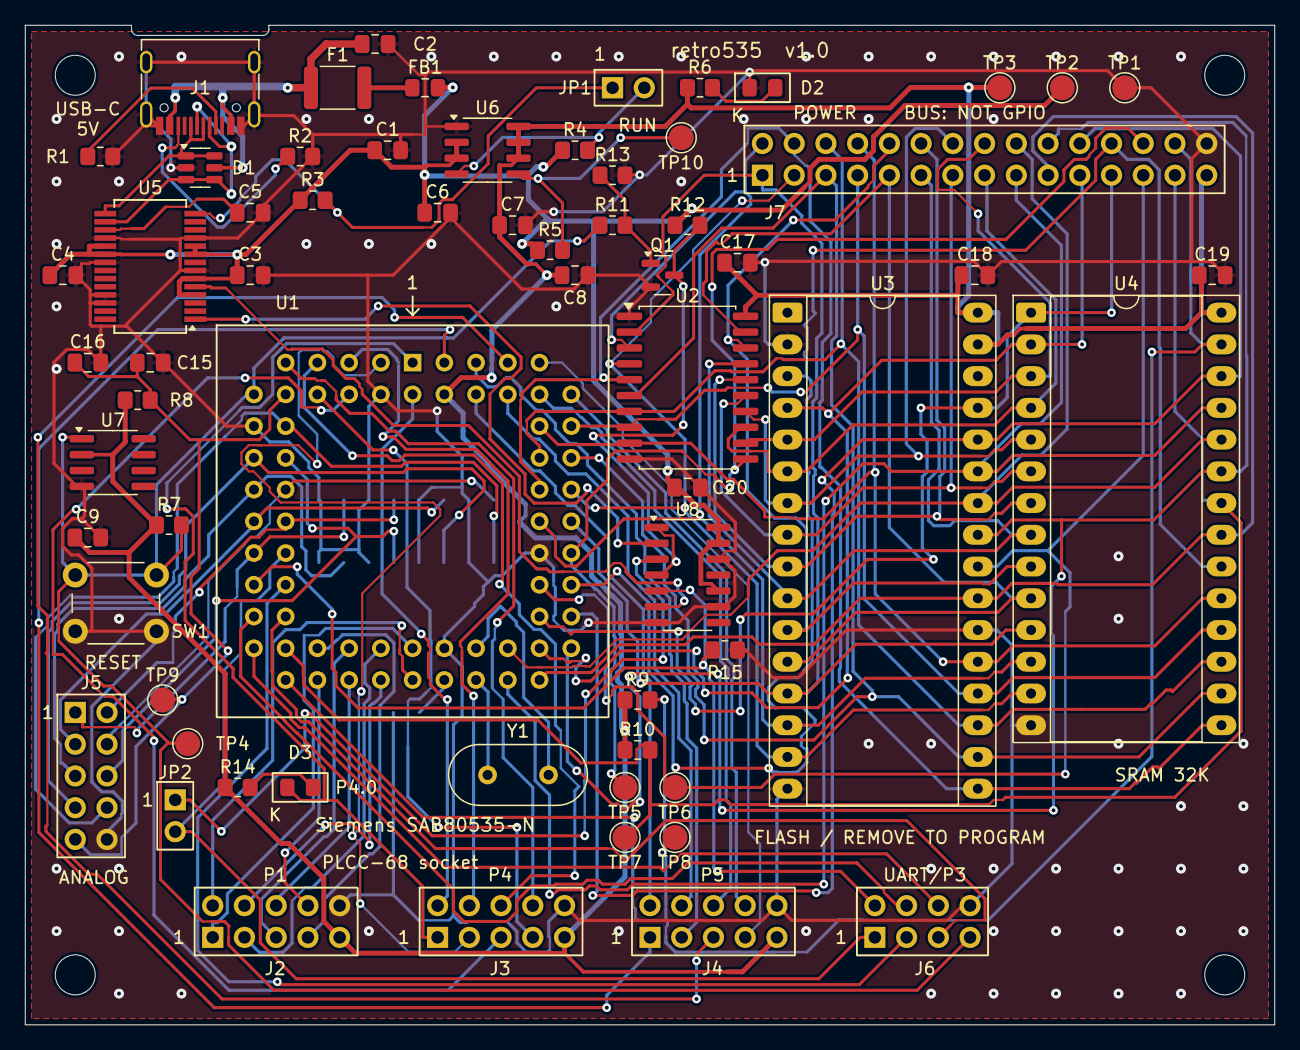
[picture p37: board retro535.kicad_pcb from above]

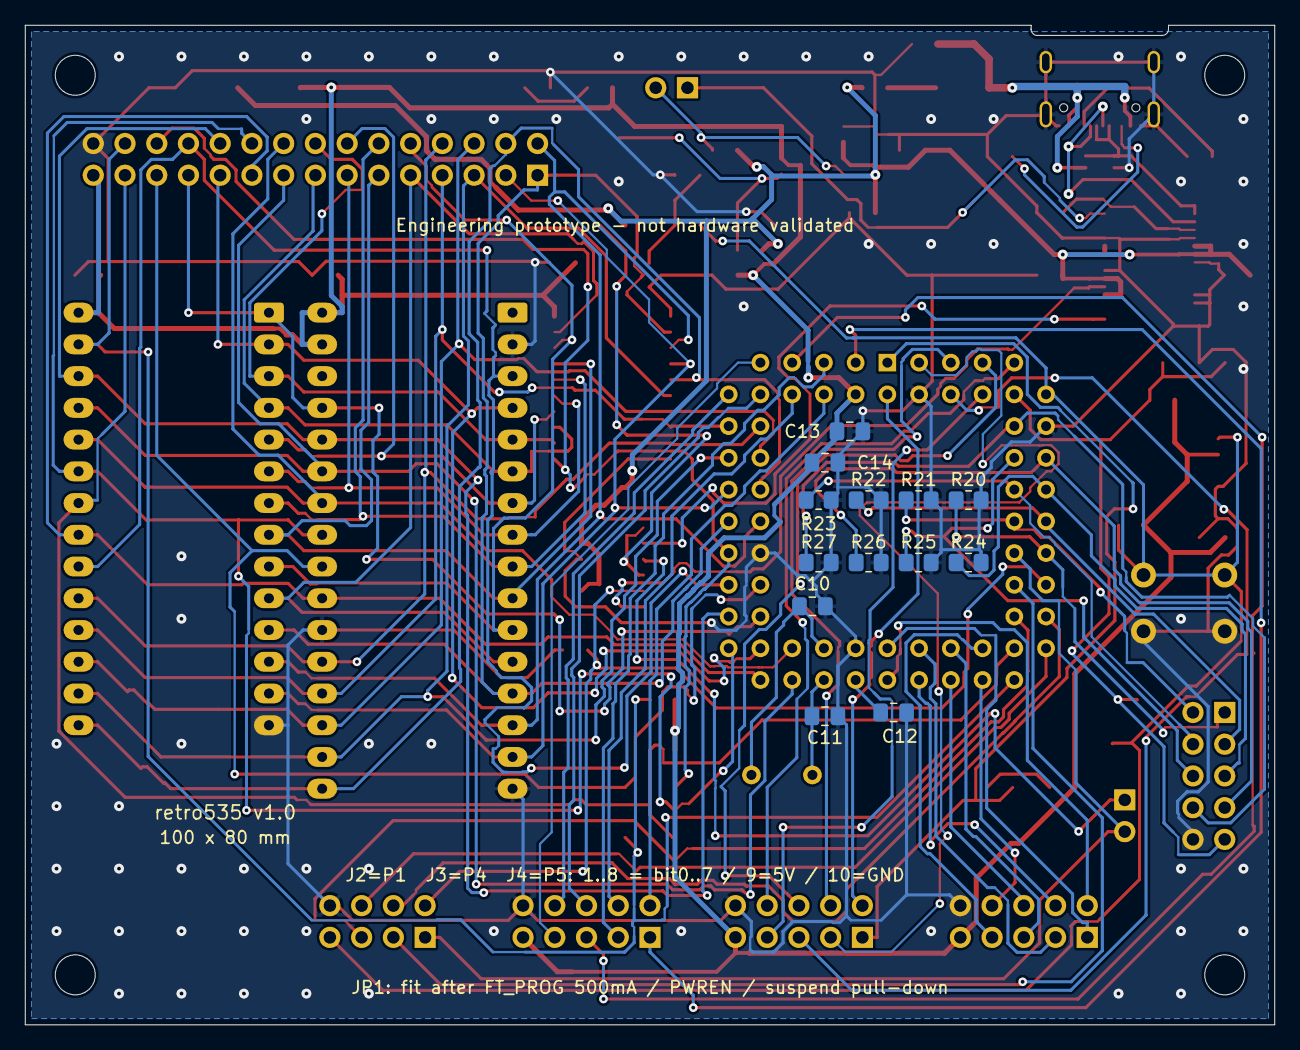
[picture p38: board retro535.kicad_pcb from below]

Board: 2 copper layers, 100.0 x 80.0 mm, 82 parts (13 on the bottom side), 91 nets.

Other parts of the board:
H1, H2, H3, H4: M3 NPTH; MountingHole_3.2mm_M3
